Ranbo-codez/chaipi/enclosure/case-landscape/tools/fit_report.txt

ChAIpi landscape case fit report (generated by enclosure/tools/build_slab.py)
size 180.0 x 76.0 x 25.9 mm
box check (layout.py): 0 collisions, 0 spots under 0.5 mm
real-mesh check: no parts cut into each other
