Ranbo-codez/chaipi/enclosure/case-portrait/tools/fit_report.txt

ChAIpi portrait case fit report (generated by enclosure/tools/build_slab.py)
size 100.0 x 148.0 x 25.9 mm
box check (layout.py): 0 collisions, 0 spots under 0.5 mm
real-mesh check: no parts cut into each other
