Ranbo-codez/chaipi/enclosure/case/tools/fit_report.txt

ChAIpi case fit report (generated by build_case.py)
closed thickness 36.3 mm; base 89.2 x 60.5 x 25.9; lid 89.2 x 53.2 x 10.4
no parts cut into each other when closed
lid swing: free from 0 to 180 degrees
