Ranbo-codez/chaipi/enclosure/case/renders/hinge.png

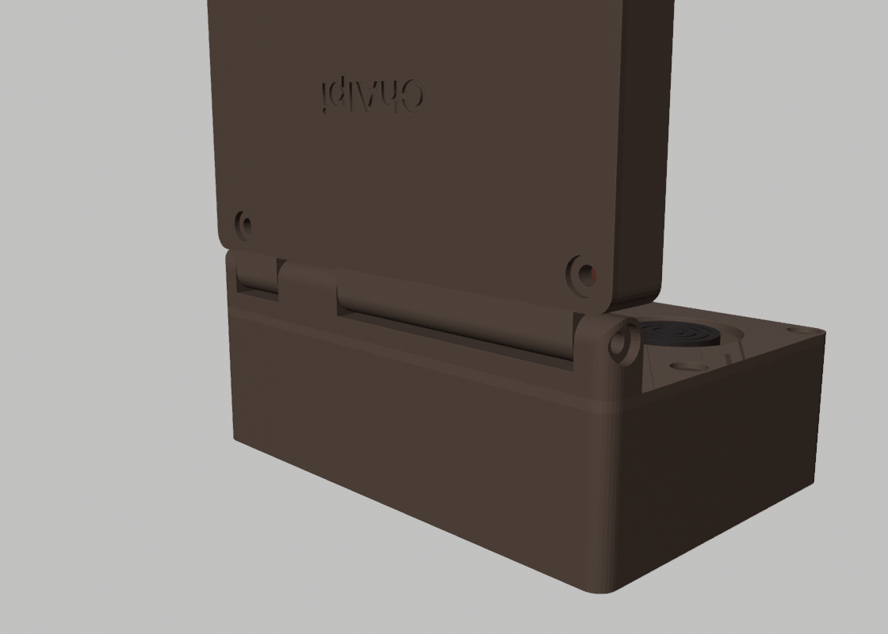
enclosure/case/renders/hinge.png
