Ranbo-codez/chaipi/enclosure/case/stl/assembly_closed.stl

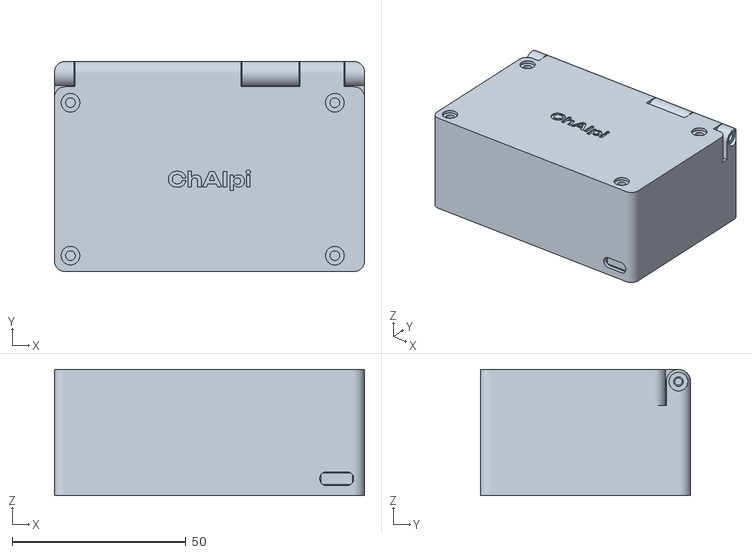
[picture p25: CAD file, 2026-10-29]
enclosure/case/stl/assembly_closed.stl
89.2 x 60.5 x 36.3
