Ranbo-codez/chaipi/enclosure/case-landscape/stl/assembly.stl

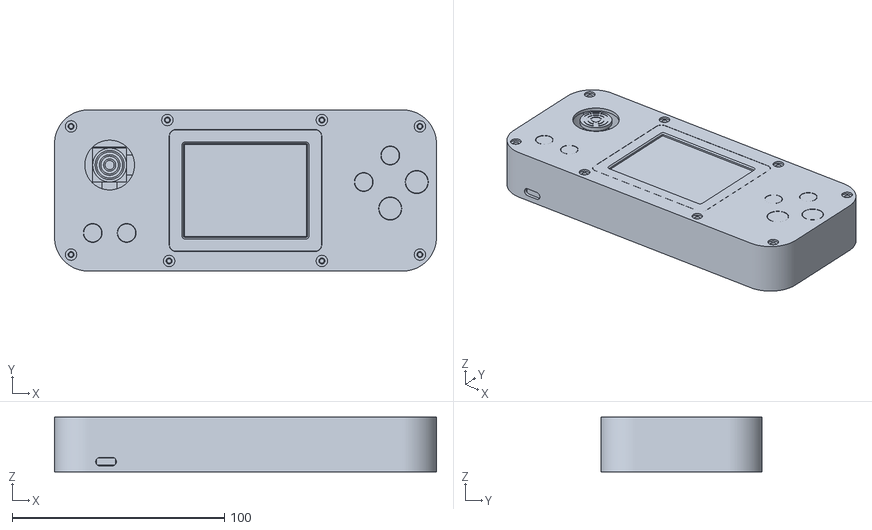
[picture p26: CAD file, 2026-10-29]
enclosure/case-landscape/stl/assembly.stl
180.0 x 76.0 x 25.9
