Ranbo-codez/chaipi/enclosure/case-portrait/stl/assembly.stl

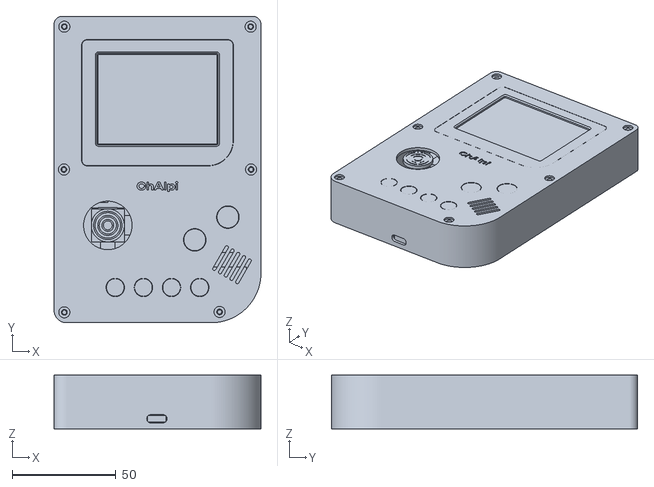
[picture p27: CAD file, 2026-10-29]
enclosure/case-portrait/stl/assembly.stl
100.0 x 148.0 x 25.9
