Ranbo-codez/chaipi/enclosure/case-landscape/stl/assembled/23 joystick.stl

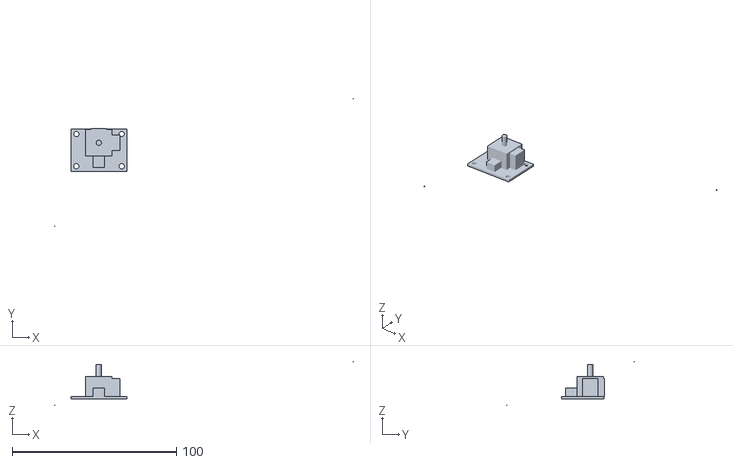
[picture p28: CAD file, 2026-10-29]
enclosure/case-landscape/stl/assembled/23 joystick.stl
182.0 x 78.0 x 26.9
