Ranbo-codez/chaipi/enclosure/case-landscape/stl/components/heatsinks.stl

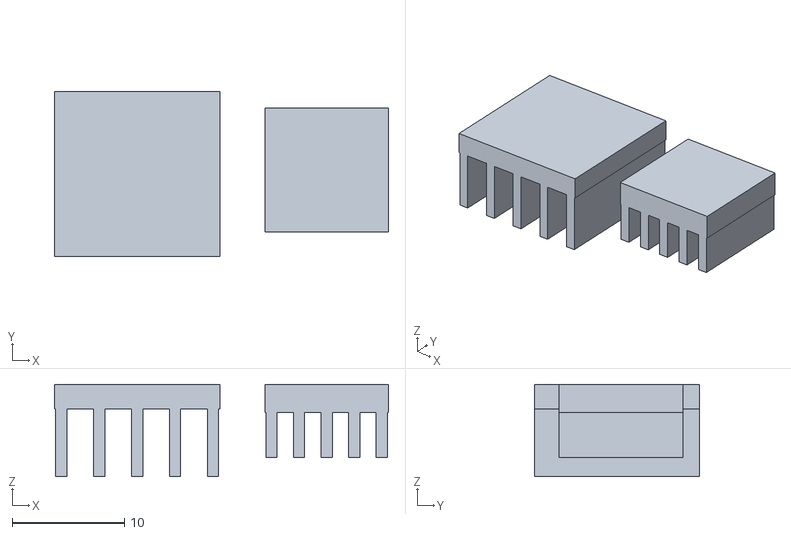
[picture p29: CAD file, 2026-10-29]
enclosure/case-landscape/stl/components/heatsinks.stl
29.7 x 14.7 x 8.20
