Ranbo-codez/chaipi/enclosure/case-landscape/stl/screen_surround.stl

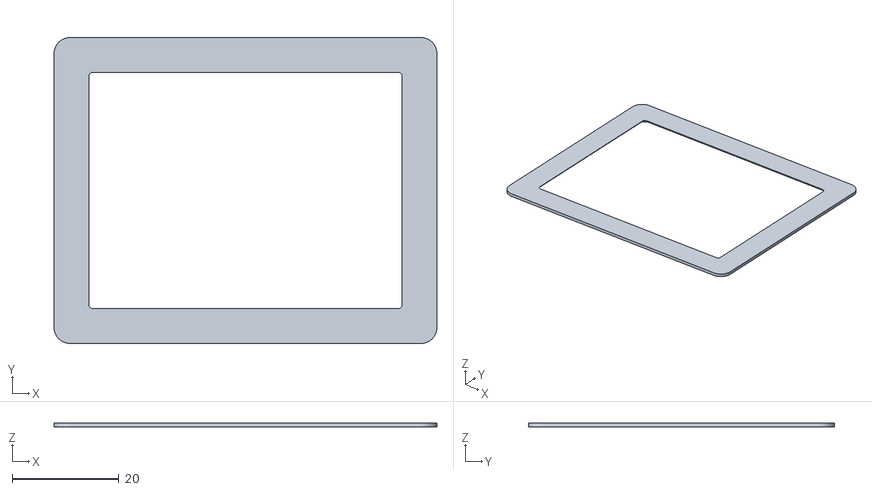
[picture p30: CAD file, 2026-10-29]
enclosure/case-landscape/stl/screen_surround.stl
71.6 x 57.2 x 0.78
