Ranbo-codez/chaipi/enclosure/case-portrait/stl/assembled/06 joystick cap.stl

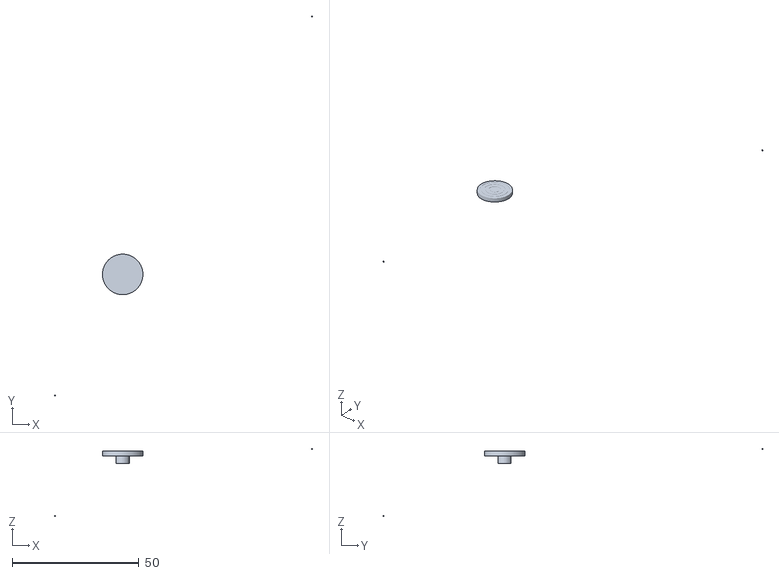
[picture p31: CAD file, 2026-10-29]
enclosure/case-portrait/stl/assembled/06 joystick cap.stl
102.0 x 150.0 x 26.9
