Ranbo-codez/chaipi/enclosure/case-portrait/stl/button_caps.stl

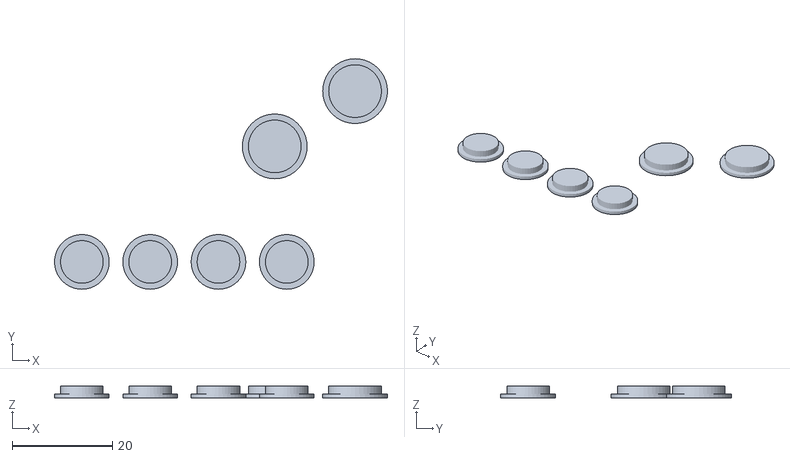
[picture p32: CAD file, 2026-10-29]
enclosure/case-portrait/stl/button_caps.stl
66.3 x 45.9 x 2.35
