Ranbo-codez/chaipi/enclosure/case-portrait/stl/components/battery.stl

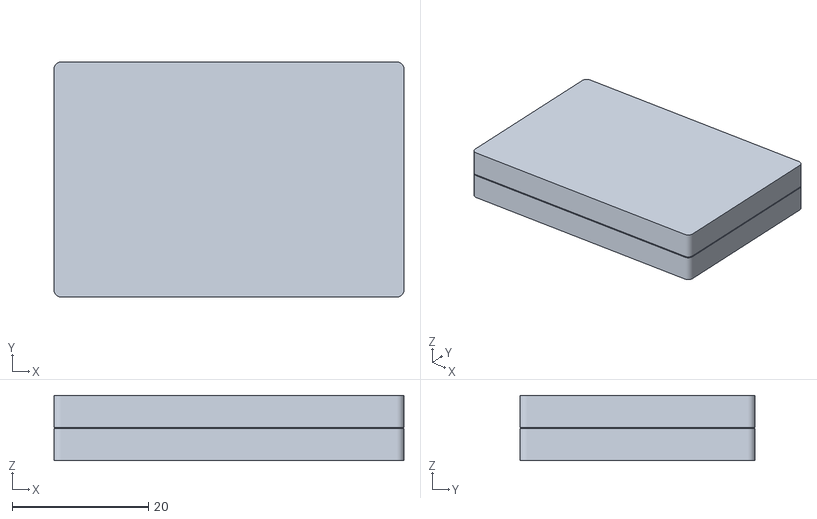
[picture p33: CAD file, 2026-10-29]
enclosure/case-portrait/stl/components/battery.stl
51.4 x 34.5 x 9.60
