Ranbo-codez/chaipi/enclosure/case/stl/assembled/03 button carrier.stl

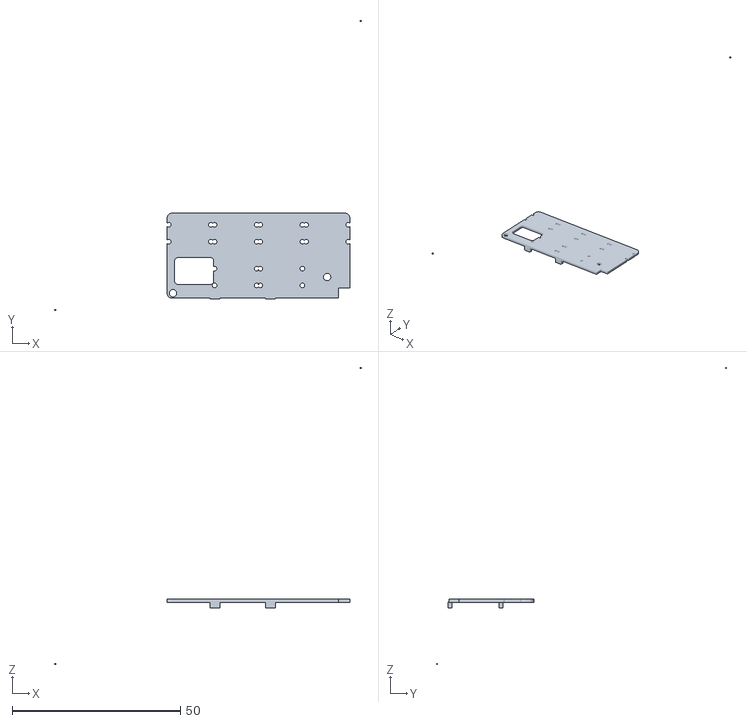
[picture p34: CAD file, 2026-10-29]
enclosure/case/stl/assembled/03 button carrier.stl
91.2 x 86.3 x 88.4
