Ranbo-codez/chaipi/enclosure/case/stl/components/screen_picture.stl

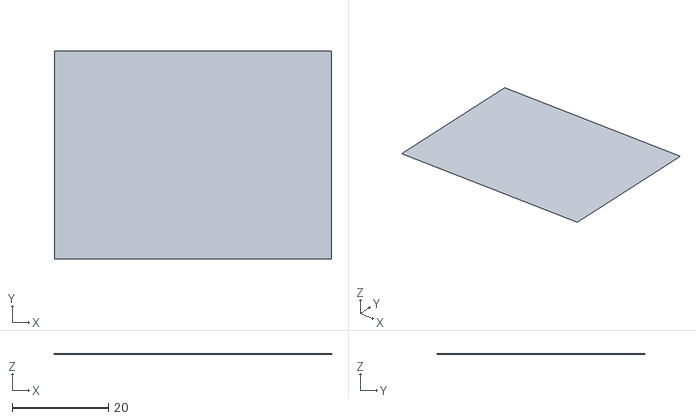
[picture p35: CAD file, 2026-10-29]
enclosure/case/stl/components/screen_picture.stl
57.6 x 43.2 x 0.1
