Ranbo-codez/chaipi/enclosure/case/stl/fit_test.stl

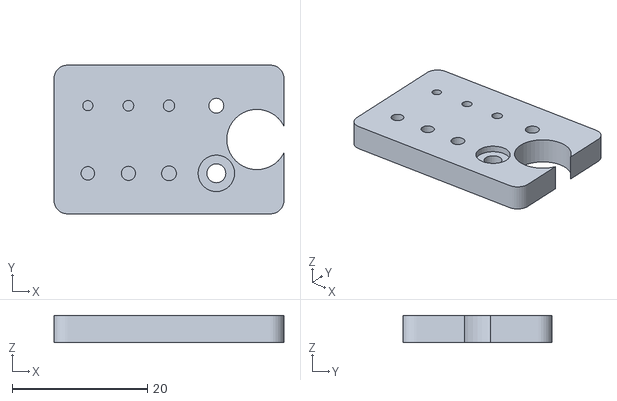
[picture p36: CAD file, 2026-10-29]
enclosure/case/stl/fit_test.stl
34.0 x 22.0 x 4.00
