Ranbo-codez/chaipi/enclosure/logo-badge/badge_ink.stl

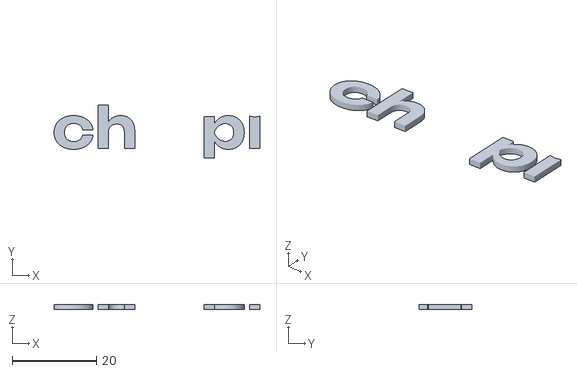
[picture p37: CAD file, 2026-10-29]
enclosure/logo-badge/badge_ink.stl
48.8 x 12.5 x 1.20
