Ranbo-codez/chaipi/enclosure/case-landscape/stl/components/Pi_connectors.stl

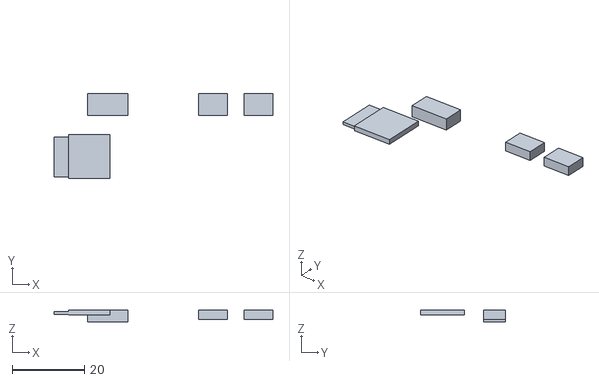
[picture p39: CAD file, 2026-10-29]
enclosure/case-landscape/stl/components/Pi_connectors.stl
60.5 x 23.4 x 3.30
