Ranbo-codez/chaipi/enclosure/case-landscape/stl/tub.stl

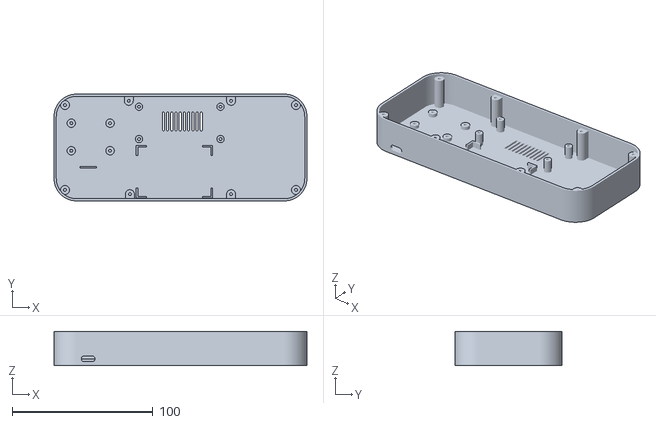
[picture p40: CAD file, 2026-10-29]
enclosure/case-landscape/stl/tub.stl
180.0 x 76.0 x 24.3
