Ranbo-codez/chaipi/enclosure/case-portrait/stl/assembled/28 USB-C breakout.stl

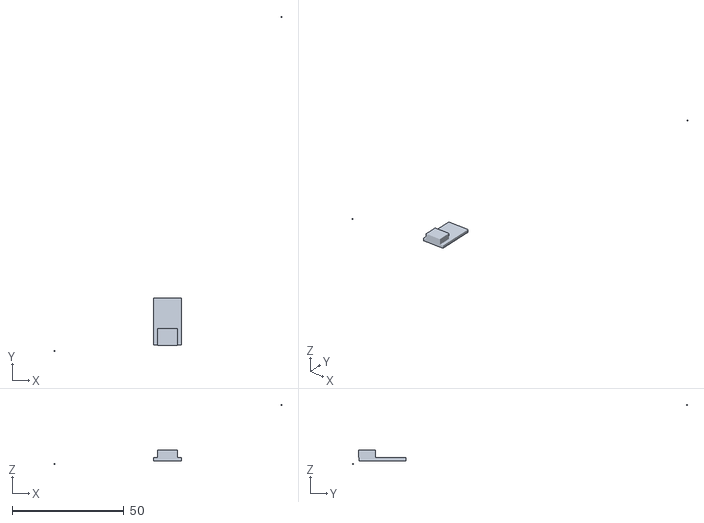
[picture p41: CAD file, 2026-10-29]
enclosure/case-portrait/stl/assembled/28 USB-C breakout.stl
102.0 x 150.0 x 26.9
