Ranbo-codez/chaipi/enclosure/case-portrait/stl/components/Pi_Zero_2_W.stl

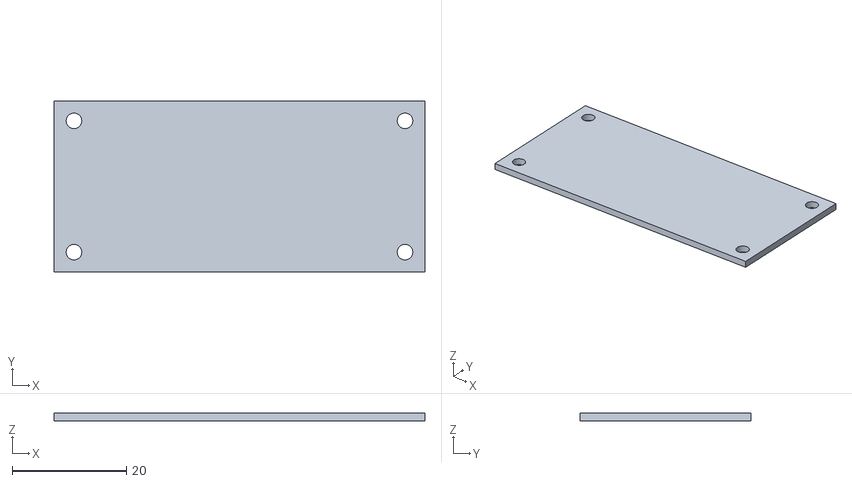
[picture p42: CAD file, 2026-10-29]
enclosure/case-portrait/stl/components/Pi_Zero_2_W.stl
65.0 x 30.0 x 1.40
