Ranbo-codez/chaipi/enclosure/case-portrait/stl/screen_surround.stl

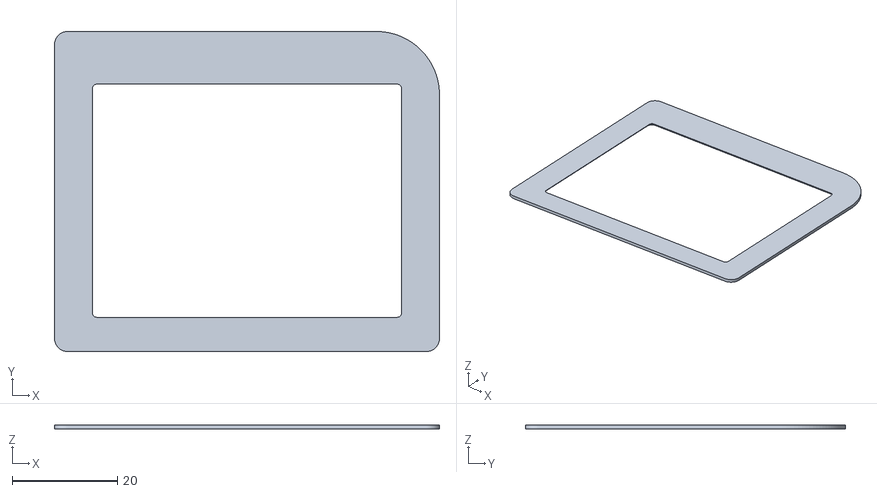
[picture p43: CAD file, 2026-10-29]
enclosure/case-portrait/stl/screen_surround.stl
73.0 x 60.7 x 0.78
