Ranbo-codez/chaipi/enclosure/case/stl/assembled/20 screen.stl

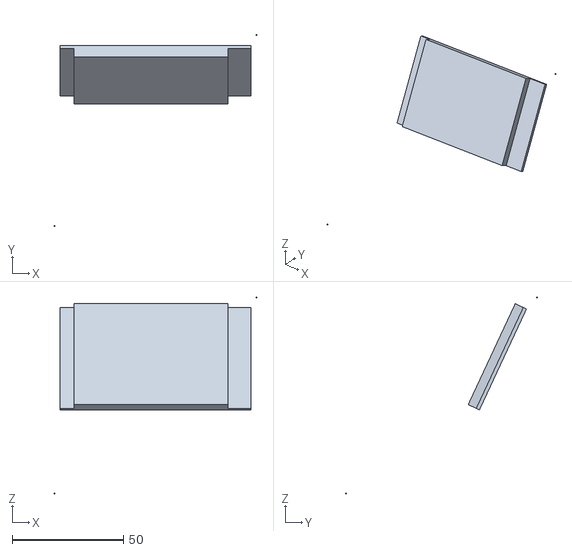
[picture p44: CAD file, 2026-10-29]
enclosure/case/stl/assembled/20 screen.stl
91.2 x 86.3 x 88.4
