Ranbo-codez/chaipi/enclosure/case/stl/lid_back_cover.stl

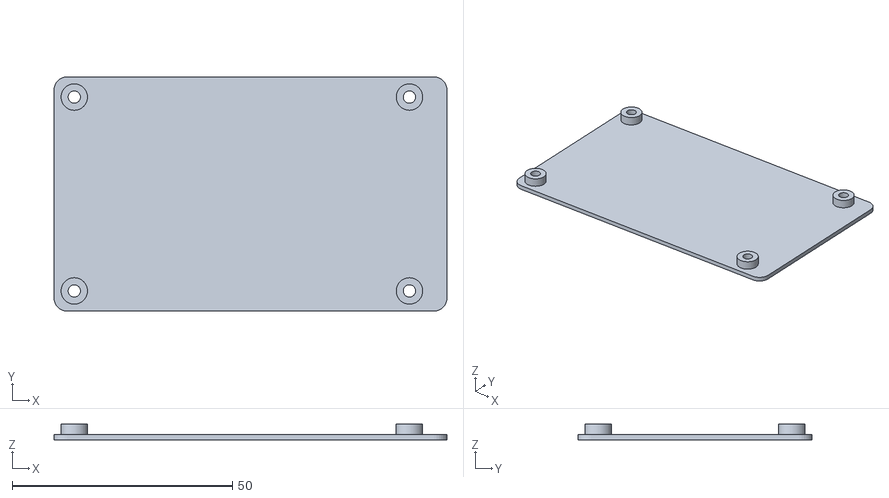
[picture p45: CAD file, 2026-10-29]
enclosure/case/stl/lid_back_cover.stl
89.2 x 53.2 x 3.60
