Ranbo-codez/chaipi/enclosure/logo-badge/badge_plate.stl

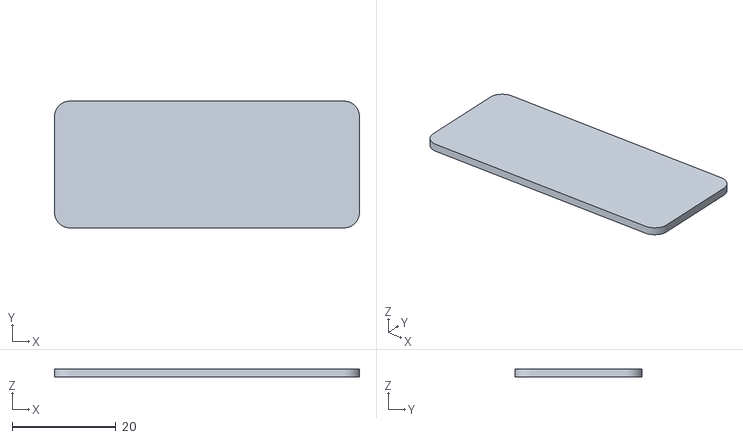
[picture p46: CAD file, 2026-10-29]
enclosure/logo-badge/badge_plate.stl
58.7 x 24.4 x 1.60
