Ranbo-codez/chaipi/enclosure/case-landscape/stl/assembled/06 joystick cap.stl

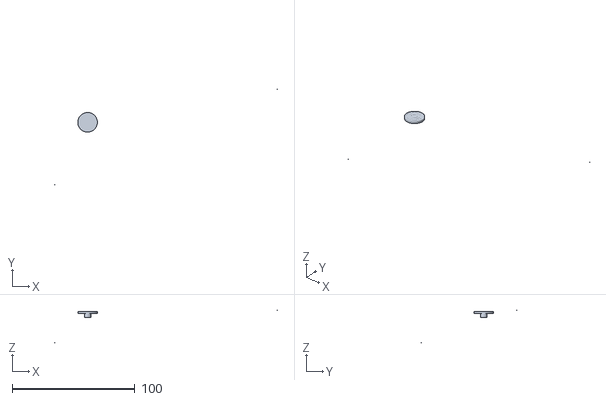
[picture p47: CAD file, 2026-10-29]
enclosure/case-landscape/stl/assembled/06 joystick cap.stl
182.0 x 78.0 x 26.9
