Ranbo-codez/chaipi/enclosure/case-landscape/stl/button_caps.stl

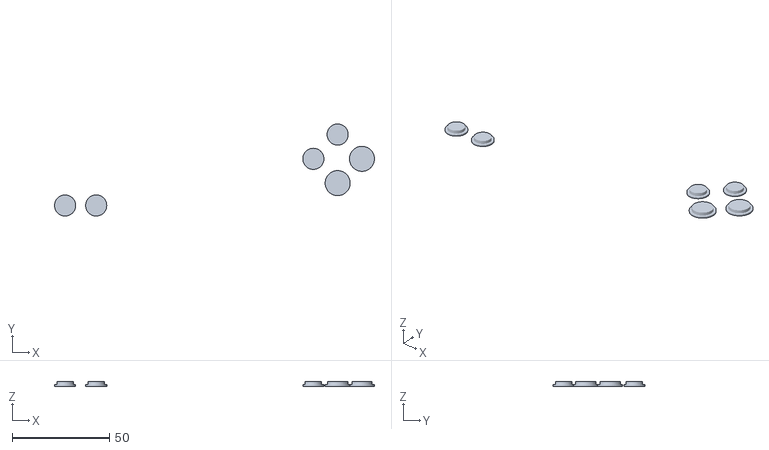
[picture p48: CAD file, 2026-10-29]
enclosure/case-landscape/stl/button_caps.stl
164.6 x 47.4 x 2.35
