Ranbo-codez/chaipi/enclosure/case-landscape/stl/components/MT3608_boost.stl

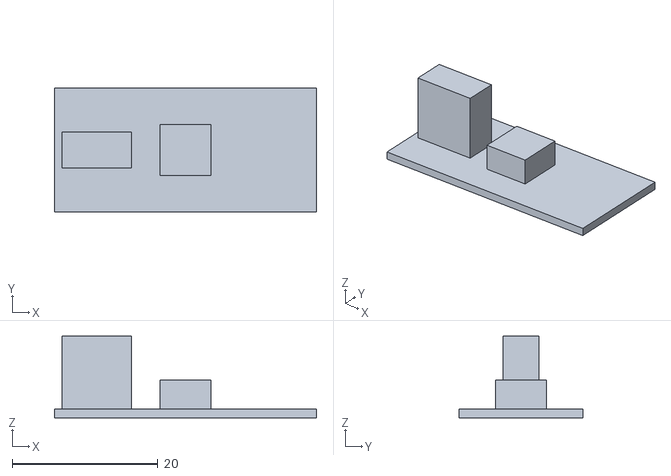
[picture p49: CAD file, 2026-10-29]
enclosure/case-landscape/stl/components/MT3608_boost.stl
36.0 x 17.0 x 11.2
