Ranbo-codez/chaipi/enclosure/case-portrait/stl/assembled/21 Pi Zero 2 W.stl

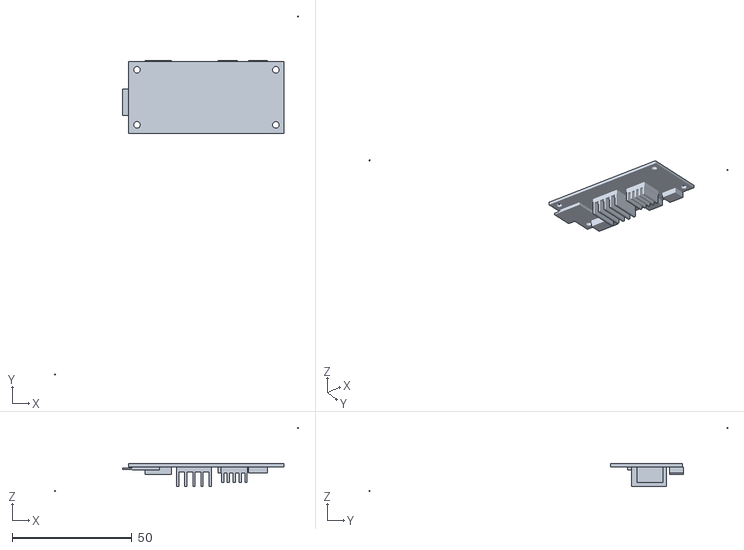
[picture p50: CAD file, 2026-10-29]
enclosure/case-portrait/stl/assembled/21 Pi Zero 2 W.stl
102.0 x 150.0 x 26.9
