Ranbo-codez/chaipi/enclosure/case-portrait/stl/joystick_cap.stl

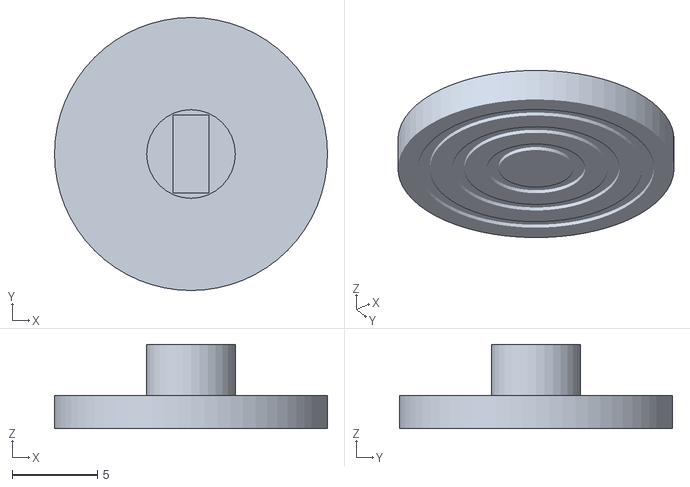
[picture p51: CAD file, 2026-10-29]
enclosure/case-portrait/stl/joystick_cap.stl
16.0 x 16.0 x 4.95
