Ranbo-codez/chaipi/enclosure/case/stl/assembled/28 USB-C breakout.stl

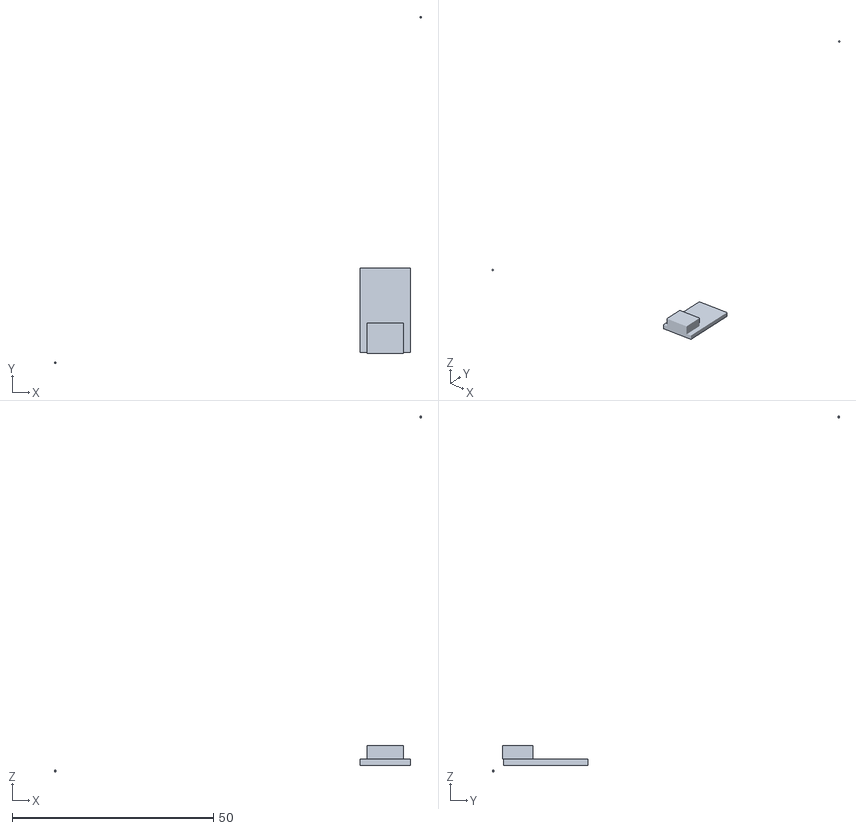
[picture p52: CAD file, 2026-10-29]
enclosure/case/stl/assembled/28 USB-C breakout.stl
91.2 x 86.3 x 88.4
