Ranbo-codez/chaipi/enclosure/case/stl/button_caps.stl

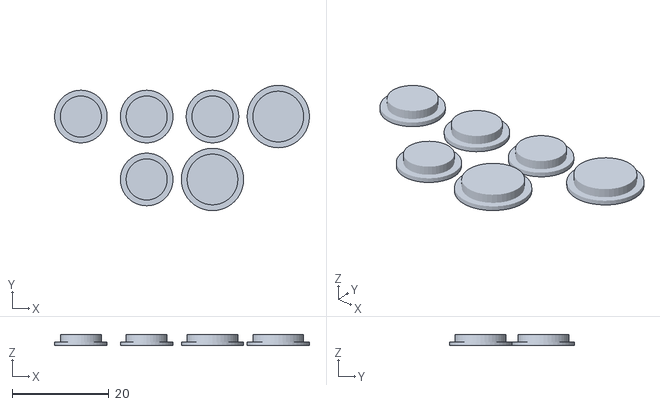
[picture p53: CAD file, 2026-10-29]
enclosure/case/stl/button_caps.stl
52.7 x 25.9 x 2.35
