Ranbo-codez/chaipi/enclosure/case/stl/components/TP4056_charger.stl

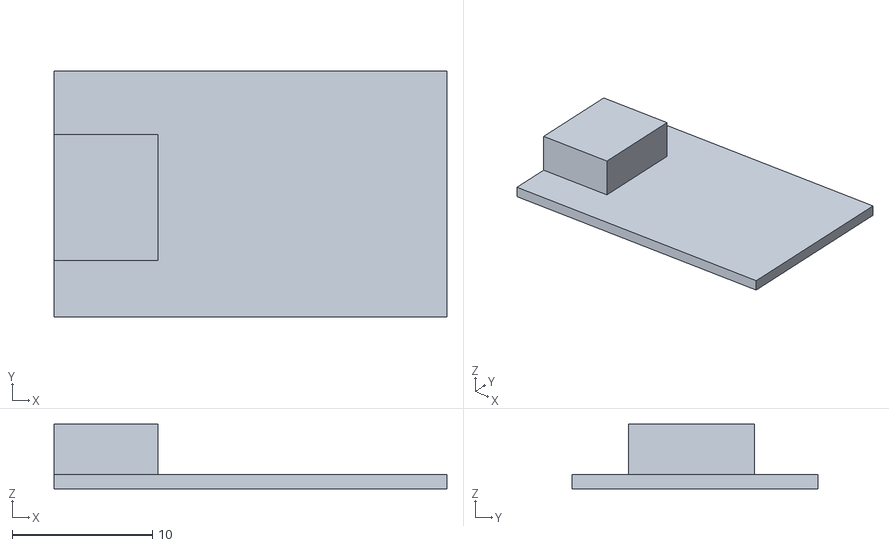
[picture p54: CAD file, 2026-10-29]
enclosure/case/stl/components/TP4056_charger.stl
28.0 x 17.5 x 4.60
