Ranbo-codez/chaipi/enclosure/logo-badge/badge_accent.stl

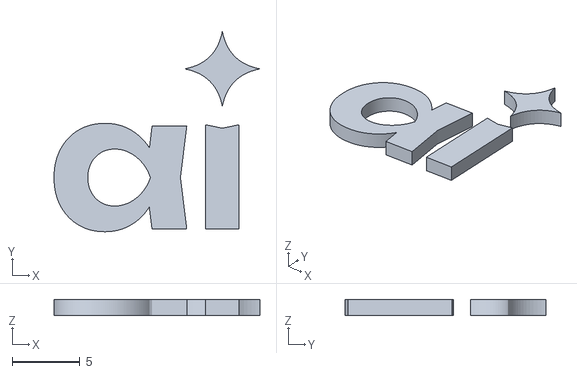
[picture p55: CAD file, 2026-10-29]
enclosure/logo-badge/badge_accent.stl
15.2 x 14.8 x 1.20
