Ranbo-codez/chaipi/enclosure/case-landscape/stl/assembled/21 Pi Zero 2 W.stl

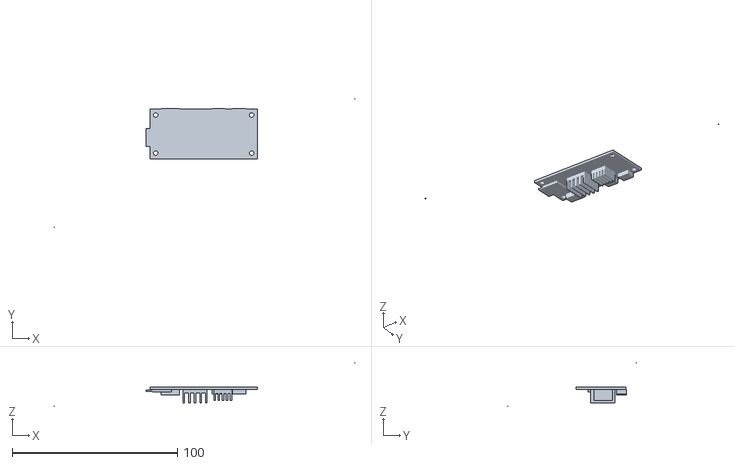
[picture p56: CAD file, 2026-10-29]
enclosure/case-landscape/stl/assembled/21 Pi Zero 2 W.stl
182.0 x 78.0 x 26.9
