Ranbo-codez/chaipi/enclosure/case-landscape/stl/button_carrier_diamond.stl

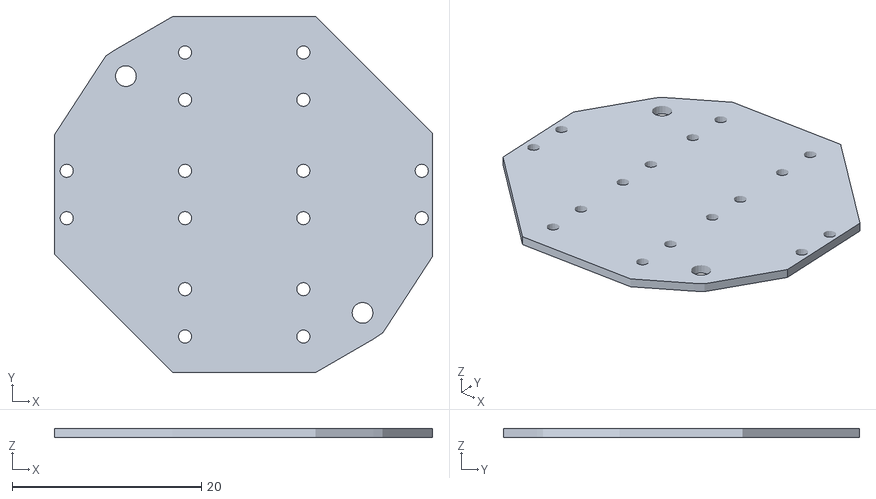
[picture p57: CAD file, 2026-10-29]
enclosure/case-landscape/stl/button_carrier_diamond.stl
40.0 x 37.6 x 1.00
