Ranbo-codez/chaipi/enclosure/case-portrait/stl/assembled/24 DS3231 clock.stl

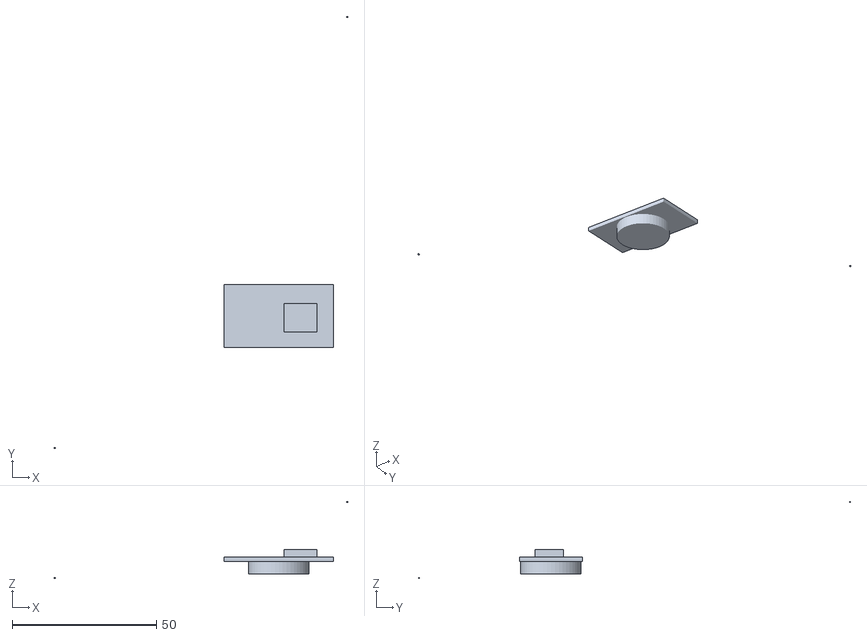
[picture p58: CAD file, 2026-10-29]
enclosure/case-portrait/stl/assembled/24 DS3231 clock.stl
102.0 x 150.0 x 26.9
