Ranbo-codez/chaipi/enclosure/case-portrait/stl/top_plate.stl

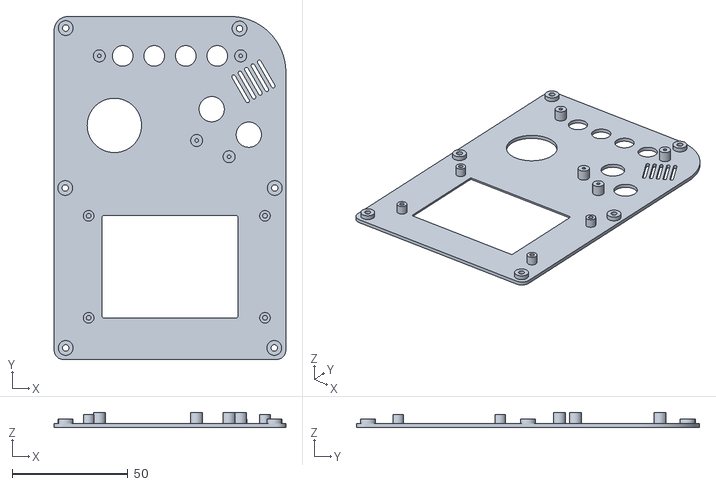
[picture p60: CAD file, 2026-10-29]
enclosure/case-portrait/stl/top_plate.stl
100.0 x 148.0 x 6.40
