Ranbo-codez/chaipi/enclosure/case/stl/assembled/06 joystick cap.stl

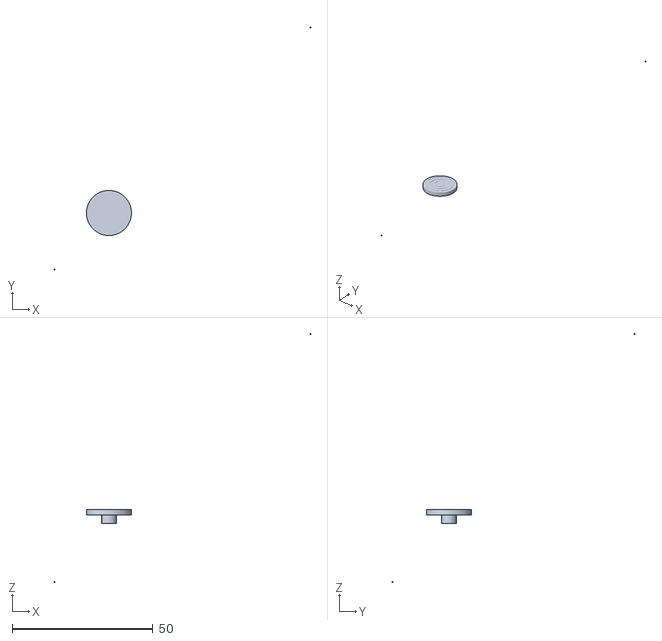
[picture p61: CAD file, 2026-10-29]
enclosure/case/stl/assembled/06 joystick cap.stl
91.2 x 86.3 x 88.4
