Ranbo-codez/chaipi/enclosure/case/stl/components/buttons.stl

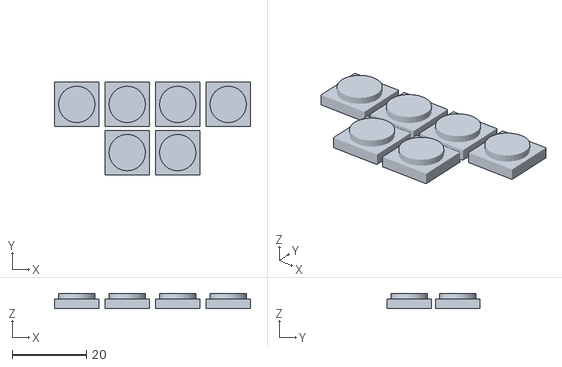
[picture p62: CAD file, 2026-10-29]
enclosure/case/stl/components/buttons.stl
52.8 x 25.0 x 4.00
