Ranbo-codez/chaipi/enclosure/logo-badge/inlay_berry.stl

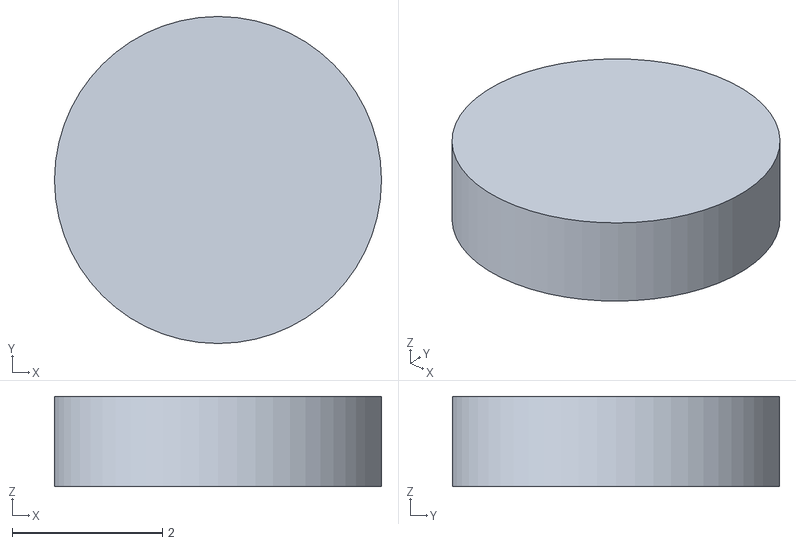
[picture p63: CAD file, 2026-10-29]
enclosure/logo-badge/inlay_berry.stl
4.36 x 4.36 x 1.20
