Ranbo-codez/chaipi/enclosure/case-landscape/stl/assembled/24 DS3231 clock.stl

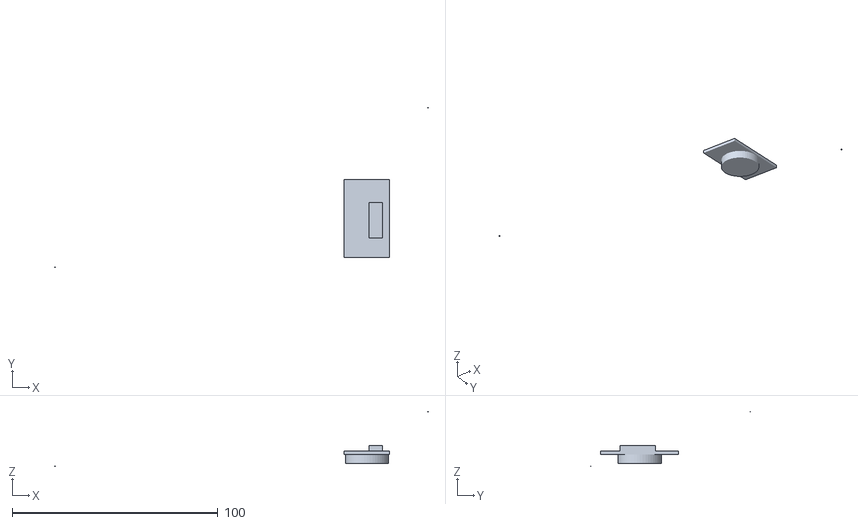
[picture p64: CAD file, 2026-10-29]
enclosure/case-landscape/stl/assembled/24 DS3231 clock.stl
182.0 x 78.0 x 26.9
