Ranbo-codez/chaipi/enclosure/case-portrait/stl/assembled/26 TP4056 charger.stl

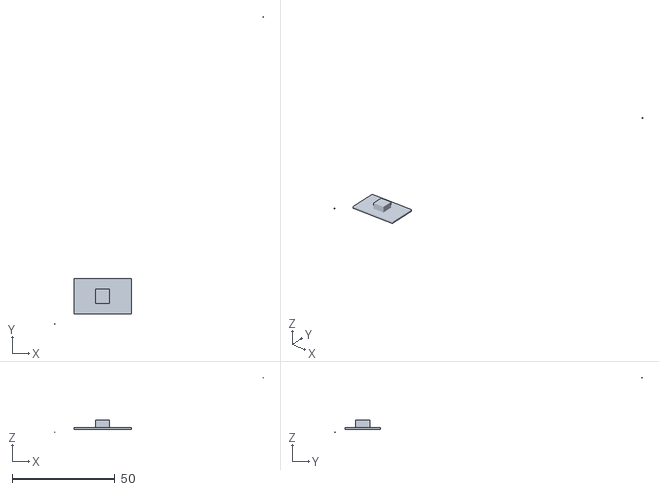
[picture p65: CAD file, 2026-10-29]
enclosure/case-portrait/stl/assembled/26 TP4056 charger.stl
102.0 x 150.0 x 26.9
