Ranbo-codez/chaipi/enclosure/case-portrait/stl/button_carrier_face_buttons.stl

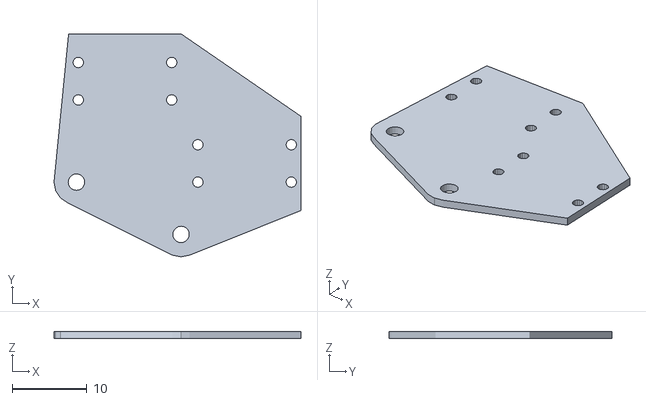
[picture p66: CAD file, 2026-10-29]
enclosure/case-portrait/stl/button_carrier_face_buttons.stl
33.1 x 29.8 x 1.00
