Ranbo-codez/chaipi/enclosure/case-portrait/stl/components/joystick.stl

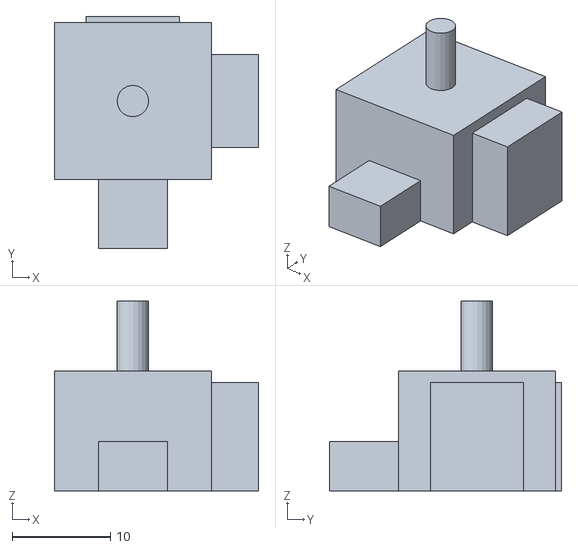
[picture p67: CAD file, 2026-10-29]
enclosure/case-portrait/stl/components/joystick.stl
20.8 x 23.6 x 19.3
