Ranbo-codez/chaipi/enclosure/case/stl/assembled/21 Pi Zero 2 W.stl

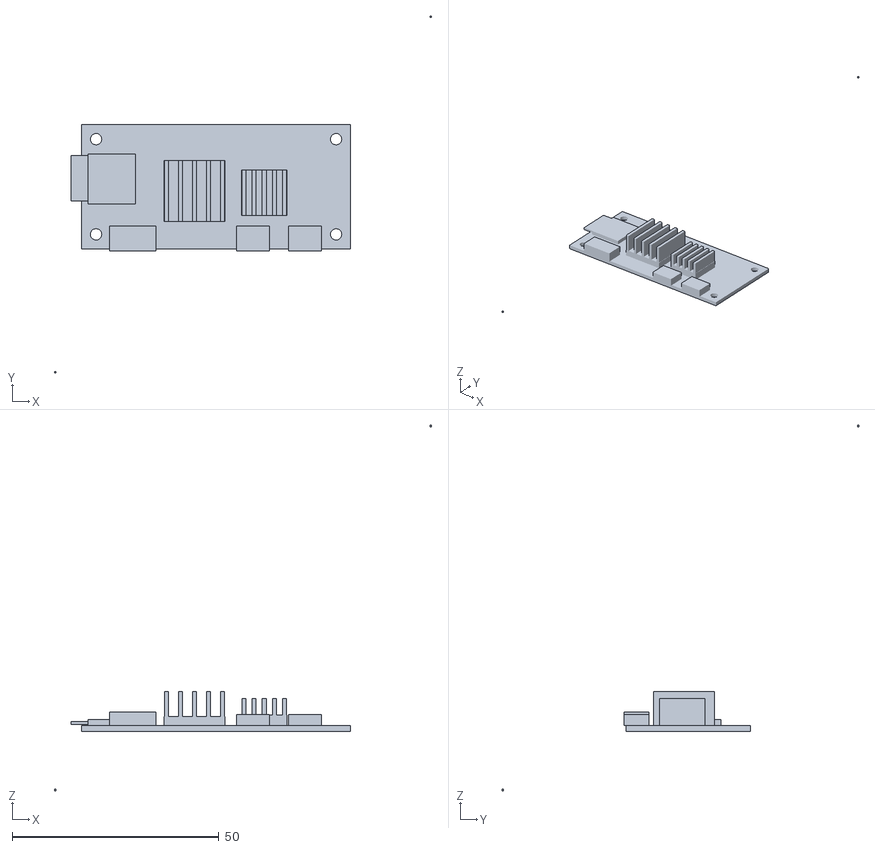
[picture p68: CAD file, 2026-10-29]
enclosure/case/stl/assembled/21 Pi Zero 2 W.stl
91.2 x 86.3 x 88.4
