Ranbo-codez/chaipi/enclosure/case/stl/button_carrier.stl

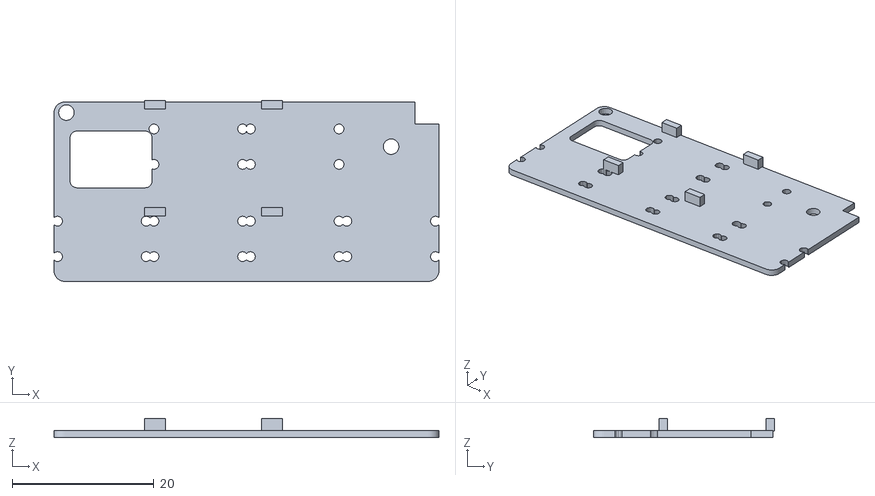
[picture p69: CAD file, 2026-10-29]
enclosure/case/stl/button_carrier.stl
54.3 x 25.5 x 2.70
