Ranbo-codez/chaipi/enclosure/case-landscape/stl/assembled/27 ADS1115.stl

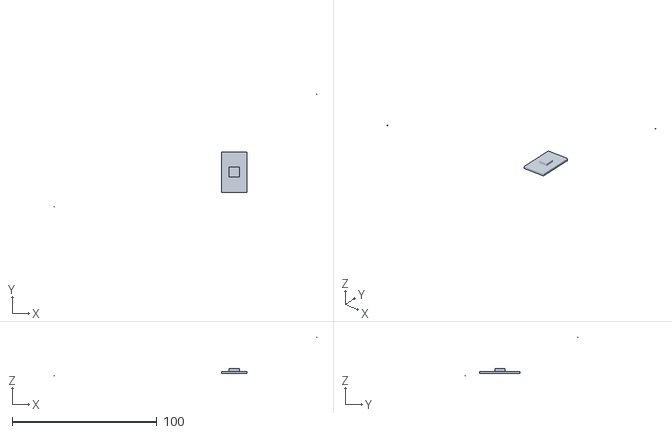
[picture p70: CAD file, 2026-10-29]
enclosure/case-landscape/stl/assembled/27 ADS1115.stl
182.0 x 78.0 x 26.9
