Ranbo-codez/chaipi/enclosure/case-portrait/stl/assembled/23 joystick.stl

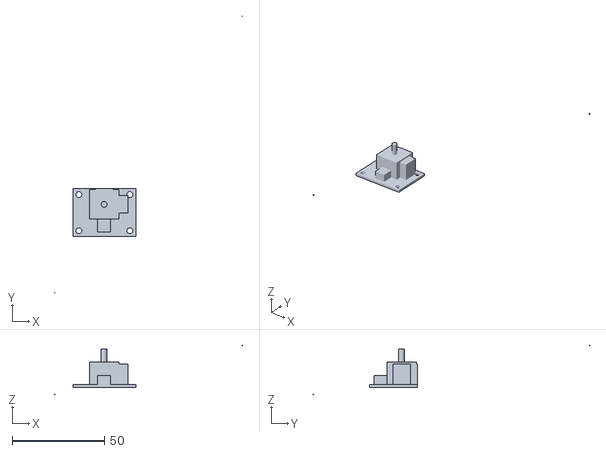
[picture p71: CAD file, 2026-10-29]
enclosure/case-portrait/stl/assembled/23 joystick.stl
102.0 x 150.0 x 26.9
