Ranbo-codez/chaipi/enclosure/case-portrait/stl/components/buttons.stl

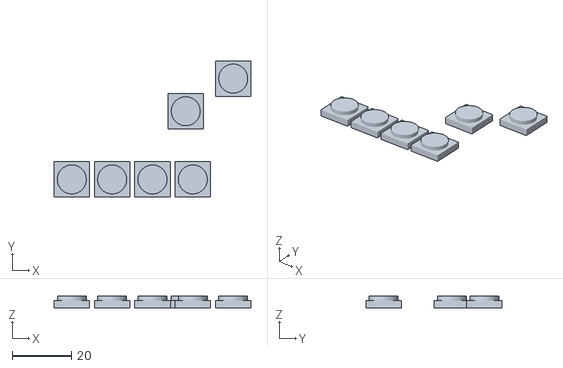
[picture p72: CAD file, 2026-10-29]
enclosure/case-portrait/stl/components/buttons.stl
66.4 x 46.0 x 4.00
