Ranbo-codez/chaipi/enclosure/case-portrait/stl/tub.stl

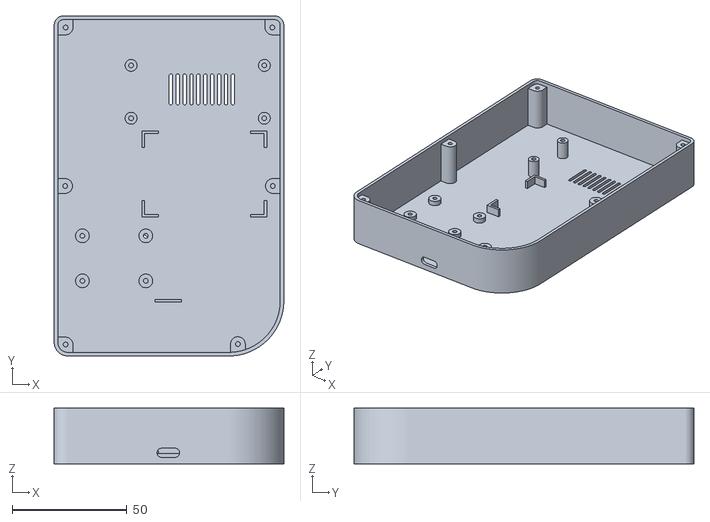
[picture p73: CAD file, 2026-10-29]
enclosure/case-portrait/stl/tub.stl
100.0 x 148.0 x 24.3
