Ranbo-codez/chaipi/enclosure/case/stl/assembled/27 ADS1115.stl

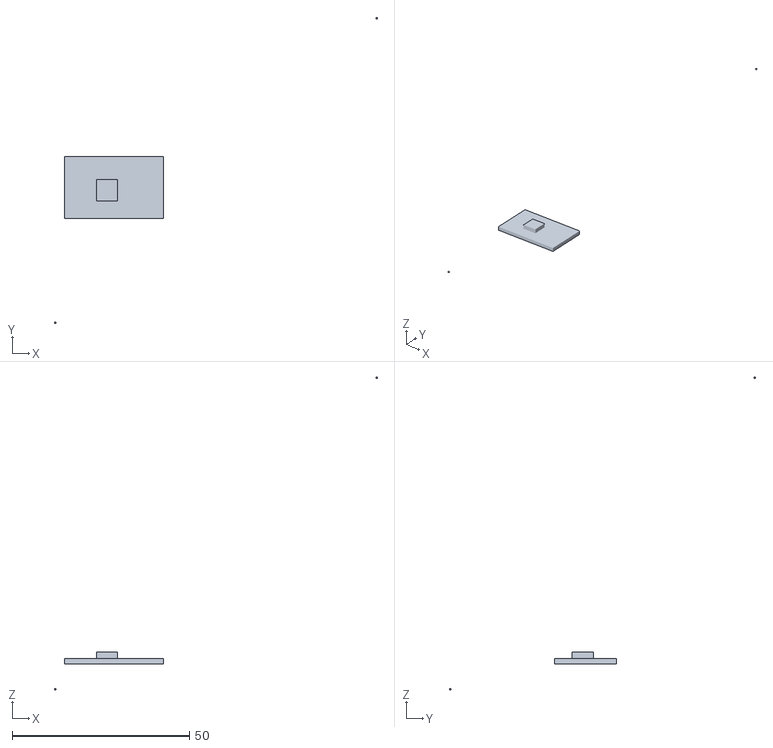
[picture p74: CAD file, 2026-10-29]
enclosure/case/stl/assembled/27 ADS1115.stl
91.2 x 86.3 x 88.4
