Ranbo-codez/chaipi/enclosure/case/stl/base_tub.stl

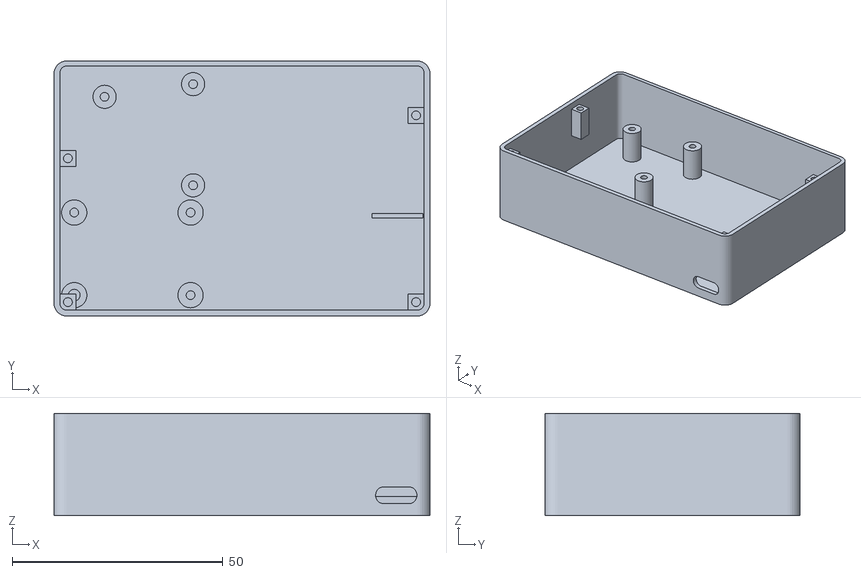
[picture p75: CAD file, 2026-10-29]
enclosure/case/stl/base_tub.stl
89.2 x 60.5 x 24.3
