Ranbo-codez/chaipi/enclosure/case/stl/components/USB-C_breakout.stl

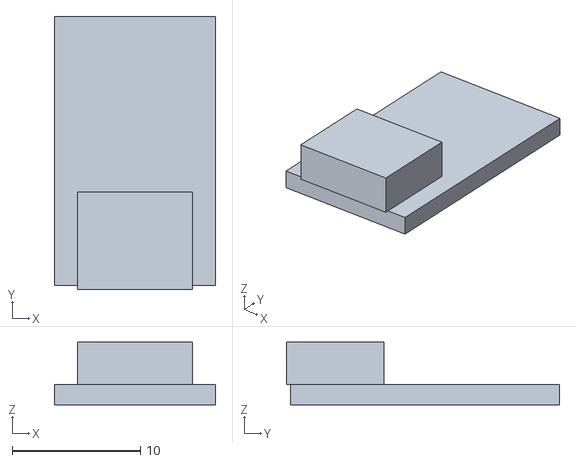
[picture p76: CAD file, 2026-10-29]
enclosure/case/stl/components/USB-C_breakout.stl
12.6 x 21.3 x 4.90
