Ranbo-codez/chaipi/enclosure/case-landscape/stl/assembled/22 battery.stl

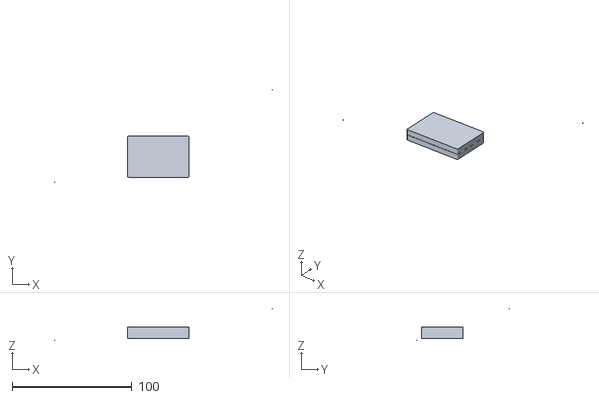
[picture p77: CAD file, 2026-10-29]
enclosure/case-landscape/stl/assembled/22 battery.stl
182.0 x 78.0 x 26.9
