Ranbo-codez/chaipi/enclosure/case-landscape/stl/components/ADS1115.stl

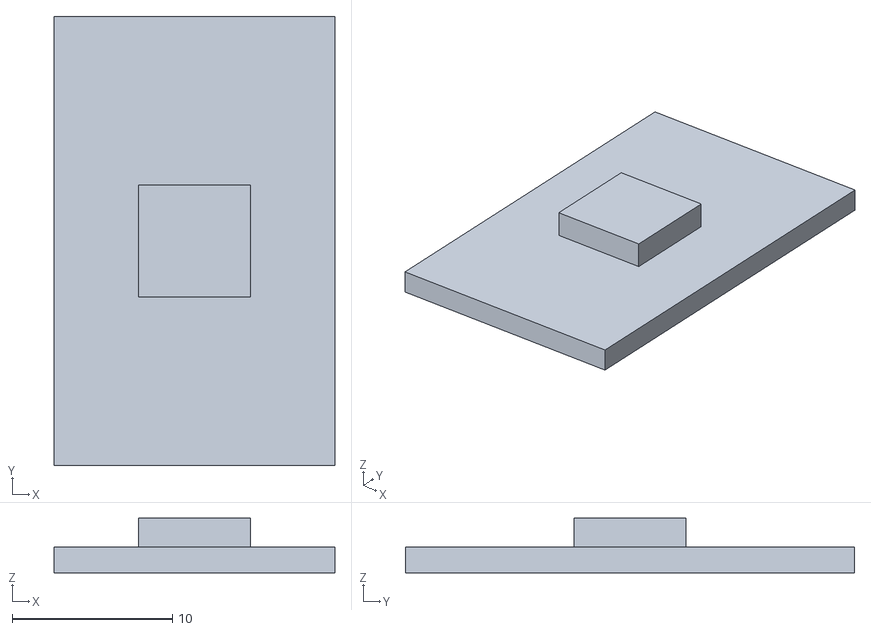
[picture p78: CAD file, 2026-10-29]
enclosure/case-landscape/stl/components/ADS1115.stl
17.5 x 28.0 x 3.40
