Ranbo-codez/chaipi/enclosure/case-landscape/stl/top_plate.stl

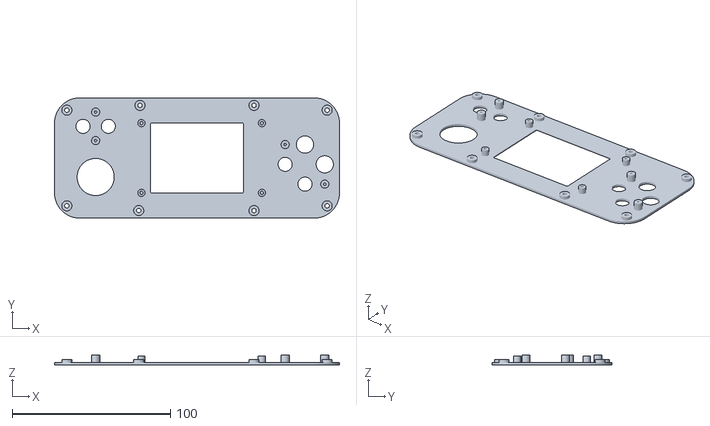
[picture p79: CAD file, 2026-10-29]
enclosure/case-landscape/stl/top_plate.stl
180.0 x 76.0 x 6.40
