Ranbo-codez/chaipi/enclosure/case-portrait/stl/assembled/22 battery.stl

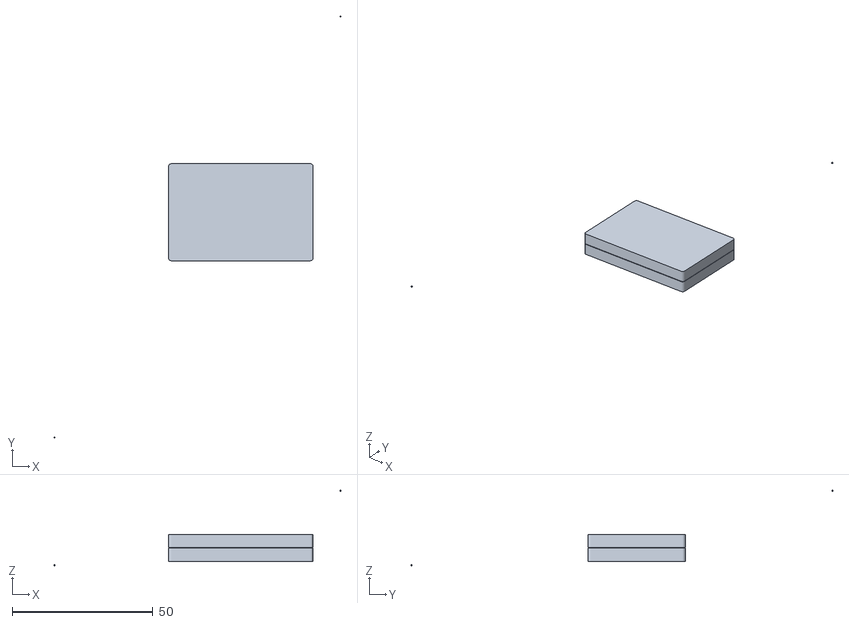
[picture p80: CAD file, 2026-10-29]
enclosure/case-portrait/stl/assembled/22 battery.stl
102.0 x 150.0 x 26.9
