Ranbo-codez/chaipi/enclosure/case-portrait/stl/button_carrier_small_keys.stl

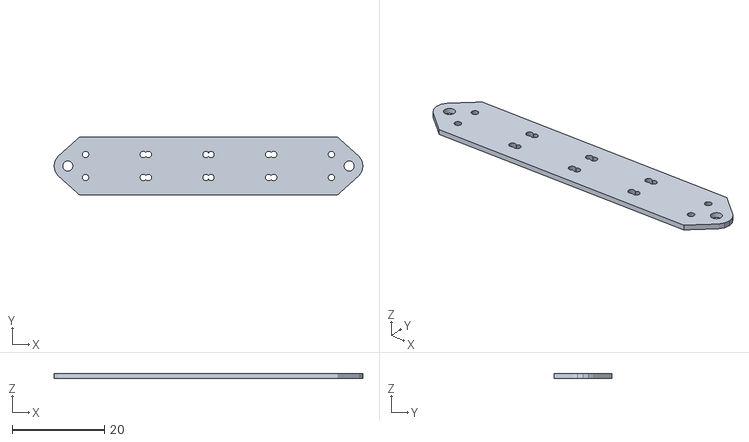
[picture p81: CAD file, 2026-10-29]
enclosure/case-portrait/stl/button_carrier_small_keys.stl
67.0 x 12.6 x 1.00
