Ranbo-codez/chaipi/enclosure/case/stl/assembled/08 lid frame.stl

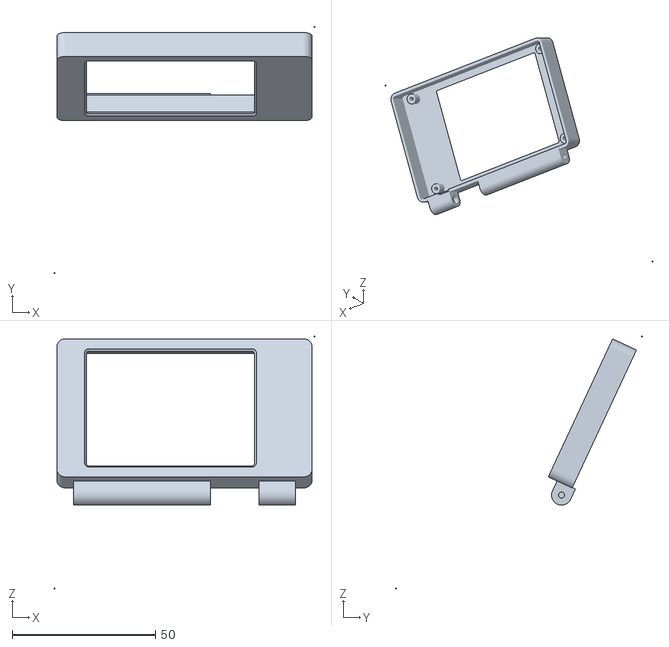
[picture p82: CAD file, 2026-10-29]
enclosure/case/stl/assembled/08 lid frame.stl
91.2 x 86.3 x 88.4
