Ranbo-codez/chaipi/enclosure/case/stl/components/screen.stl

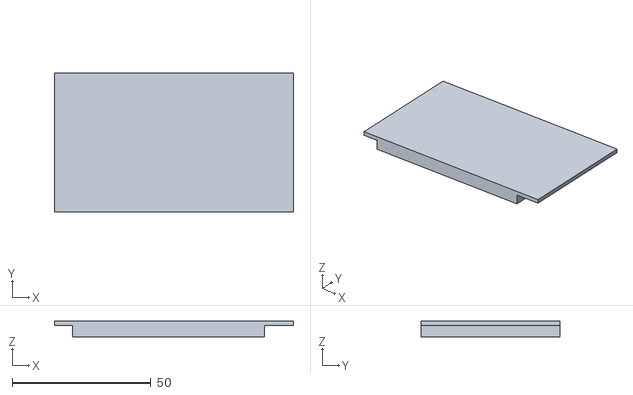
[picture p83: CAD file, 2026-10-29]
enclosure/case/stl/components/screen.stl
86.0 x 50.0 x 5.60
