Ranbo-codez/chaipi/enclosure/case/stl/hinge_block.stl

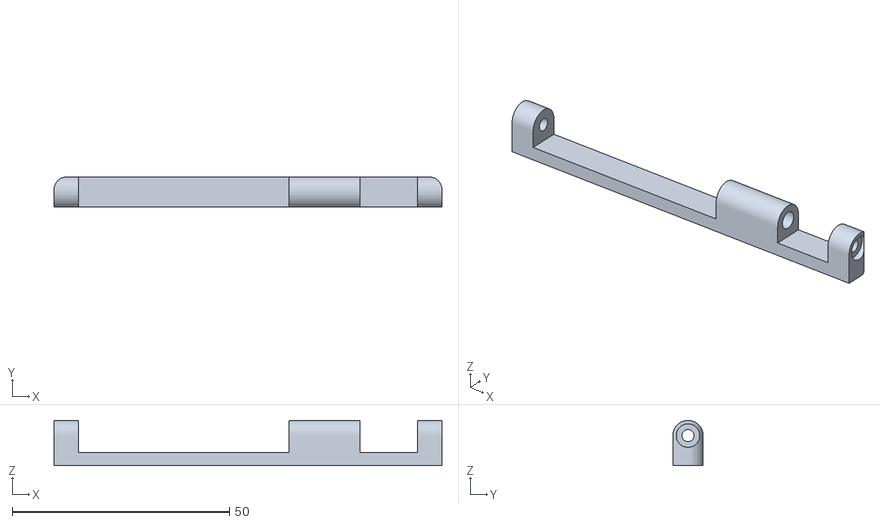
[picture p84: CAD file, 2026-10-29]
enclosure/case/stl/hinge_block.stl
89.2 x 7.00 x 10.4
