Ranbo-codez/chaipi/enclosure/case-landscape/stl/assembled/01 tub.stl

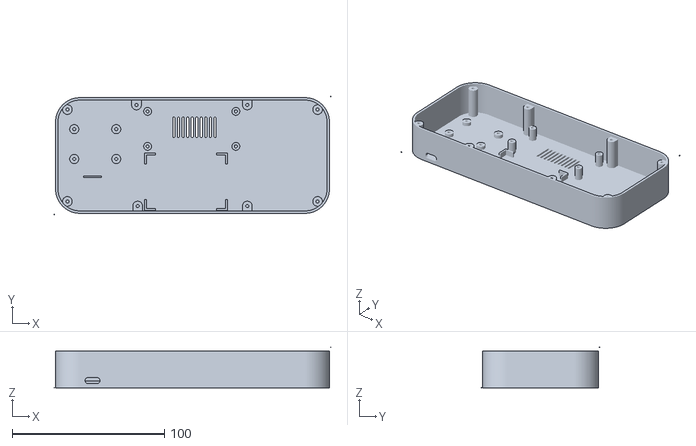
[picture p85: CAD file, 2026-10-29]
enclosure/case-landscape/stl/assembled/01 tub.stl
182.0 x 78.0 x 26.9
