Ranbo-codez/chaipi/enclosure/case-landscape/stl/button_carrier_left_keys.stl

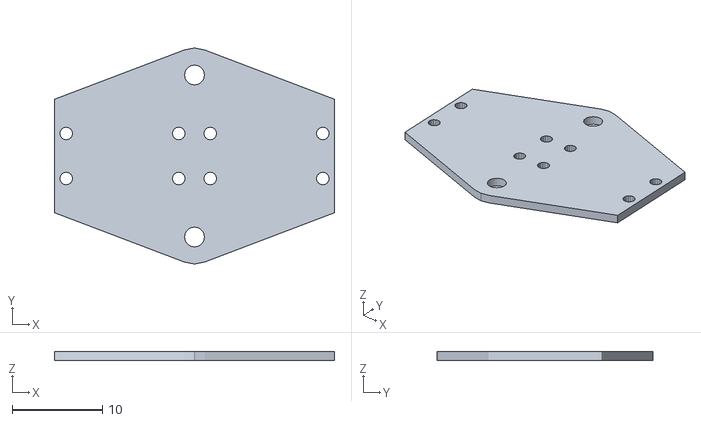
[picture p86: CAD file, 2026-10-29]
enclosure/case-landscape/stl/button_carrier_left_keys.stl
31.1 x 24.0 x 1.00
