Ranbo-codez/chaipi/enclosure/case-landscape/stl/components/screen_picture.stl

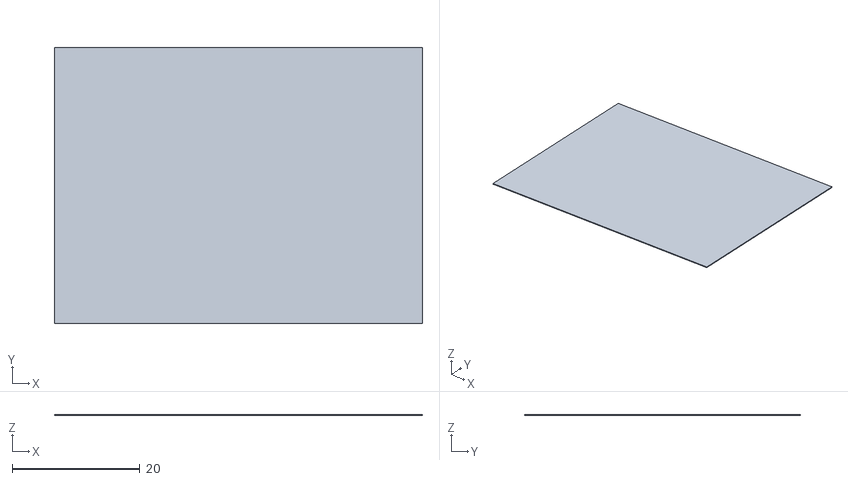
[picture p87: CAD file, 2026-10-29]
enclosure/case-landscape/stl/components/screen_picture.stl
57.6 x 43.2 x 0.16
