Ranbo-codez/chaipi/enclosure/case-portrait/stl/assembled/02 top plate.stl

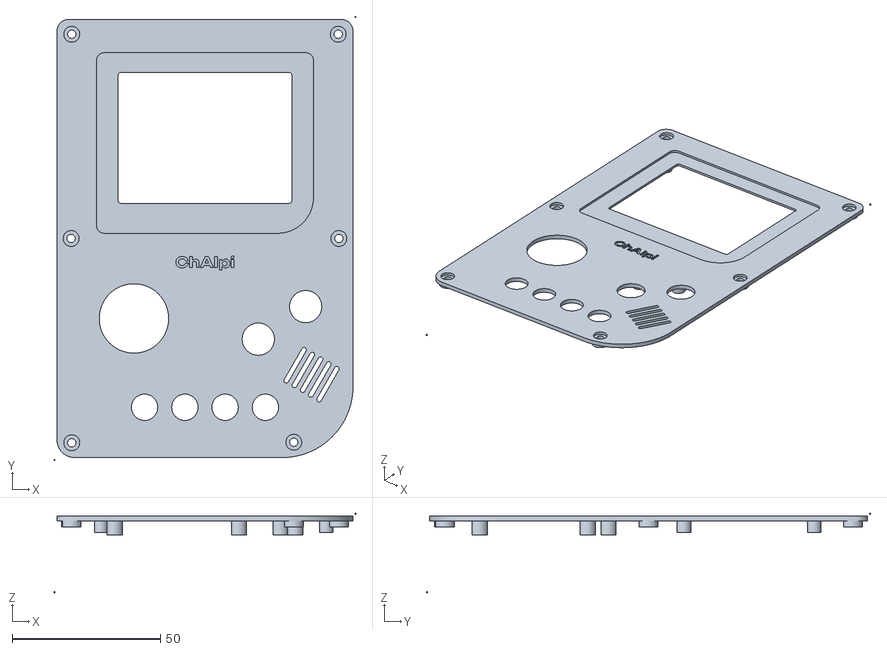
[picture p88: CAD file, 2026-10-29]
enclosure/case-portrait/stl/assembled/02 top plate.stl
102.0 x 150.0 x 26.9
