Ranbo-codez/chaipi/enclosure/case/stl/assembled/24 DS3231 clock.stl

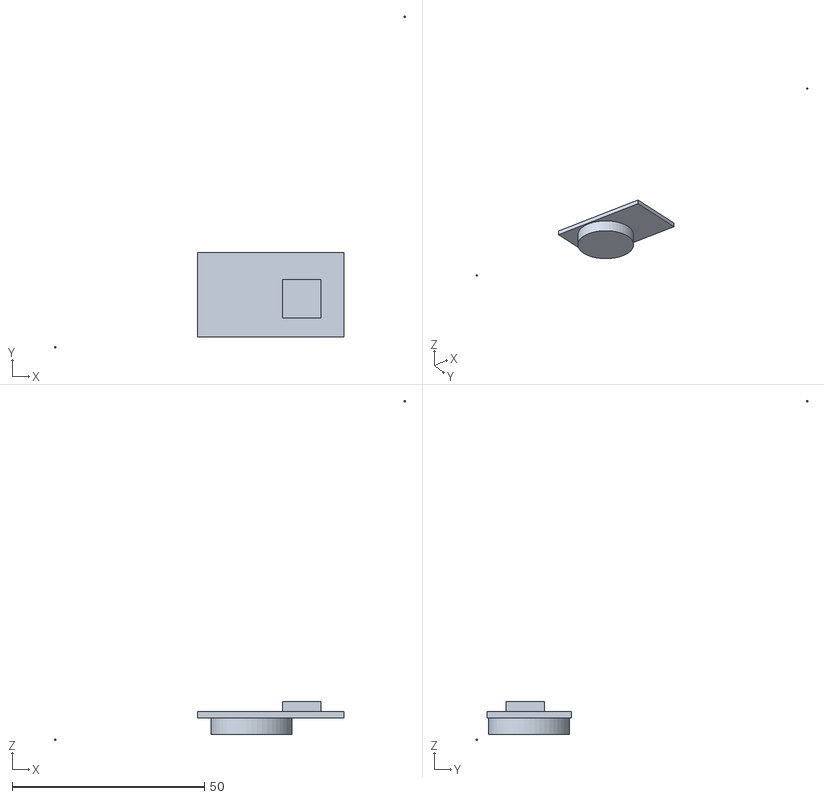
[picture p89: CAD file, 2026-10-29]
enclosure/case/stl/assembled/24 DS3231 clock.stl
91.2 x 86.3 x 88.4
