Ranbo-codez/chaipi/enclosure/case/stl/base_top_plate.stl

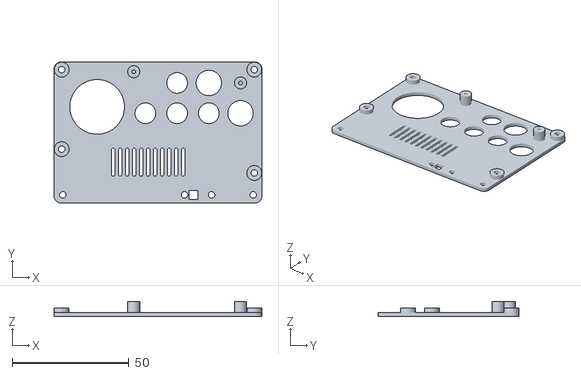
[picture p90: CAD file, 2026-10-29]
enclosure/case/stl/base_top_plate.stl
89.2 x 60.5 x 6.40
