Ranbo-codez/chaipi/enclosure/logo-badge/badge_one_piece.stl

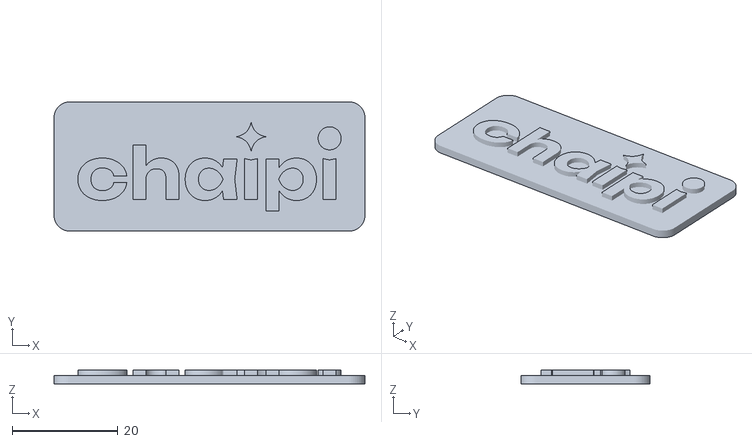
[picture p91: CAD file, 2026-10-29]
enclosure/logo-badge/badge_one_piece.stl
58.7 x 24.4 x 2.60
