Ranbo-codez/chaipi/enclosure/case-landscape/stl/assembled/04 button carrier left keys.stl

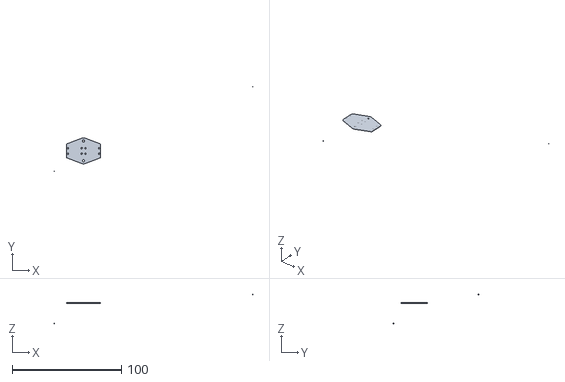
[picture p92: CAD file, 2026-10-29]
enclosure/case-landscape/stl/assembled/04 button carrier left keys.stl
182.0 x 78.0 x 26.9
