Ranbo-codez/chaipi/enclosure/case-portrait/stl/components/joystick_board.stl

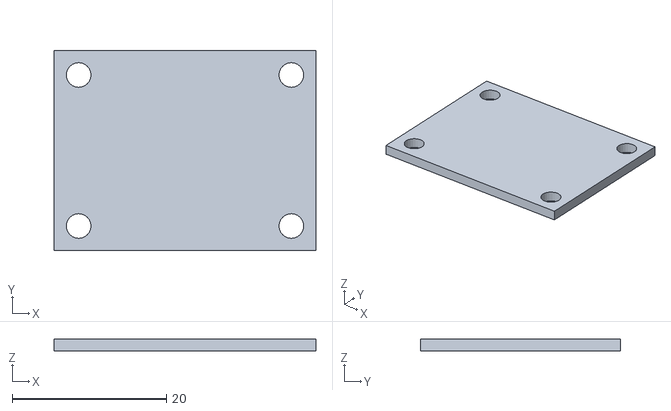
[picture p93: CAD file, 2026-10-29]
enclosure/case-portrait/stl/components/joystick_board.stl
34.0 x 26.0 x 1.60
