Ranbo-codez/chaipi/enclosure/case/stl/assembled/22 battery.stl

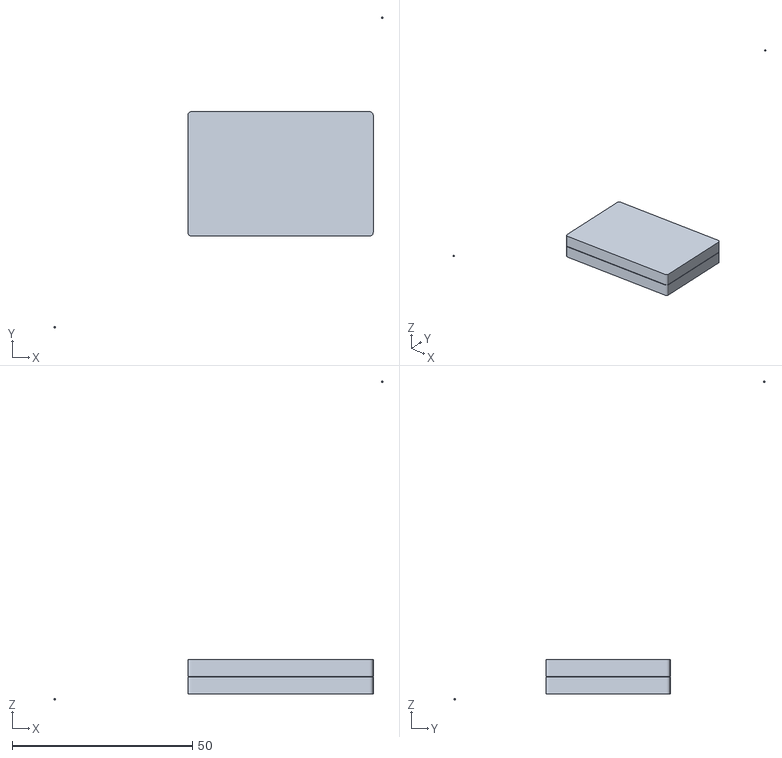
[picture p94: CAD file, 2026-10-29]
enclosure/case/stl/assembled/22 battery.stl
91.2 x 86.3 x 88.4
