Ranbo-codez/chaipi/enclosure/case/stl/lid_frame.stl

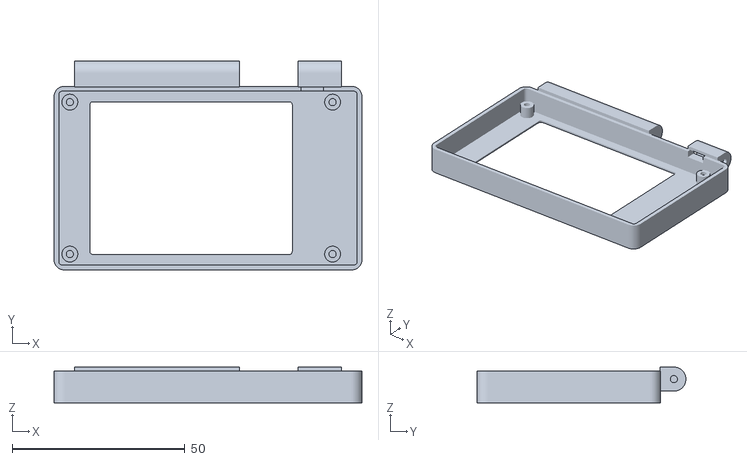
[picture p95: CAD file, 2026-10-29]
enclosure/case/stl/lid_frame.stl
89.2 x 60.5 x 10.4
