Ranbo-codez/chaipi/enclosure/case-landscape/stl/assembled/29 buttons.stl

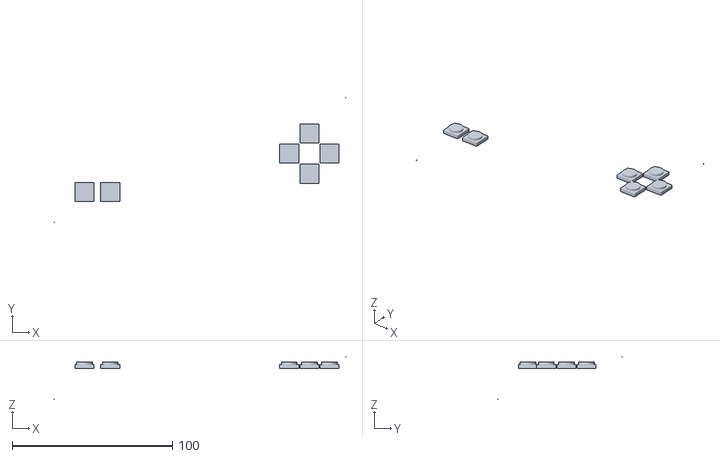
[picture p96: CAD file, 2026-10-29]
enclosure/case-landscape/stl/assembled/29 buttons.stl
182.0 x 78.0 x 26.9
