Ranbo-codez/chaipi/enclosure/case-portrait/stl/assembled/29 buttons.stl

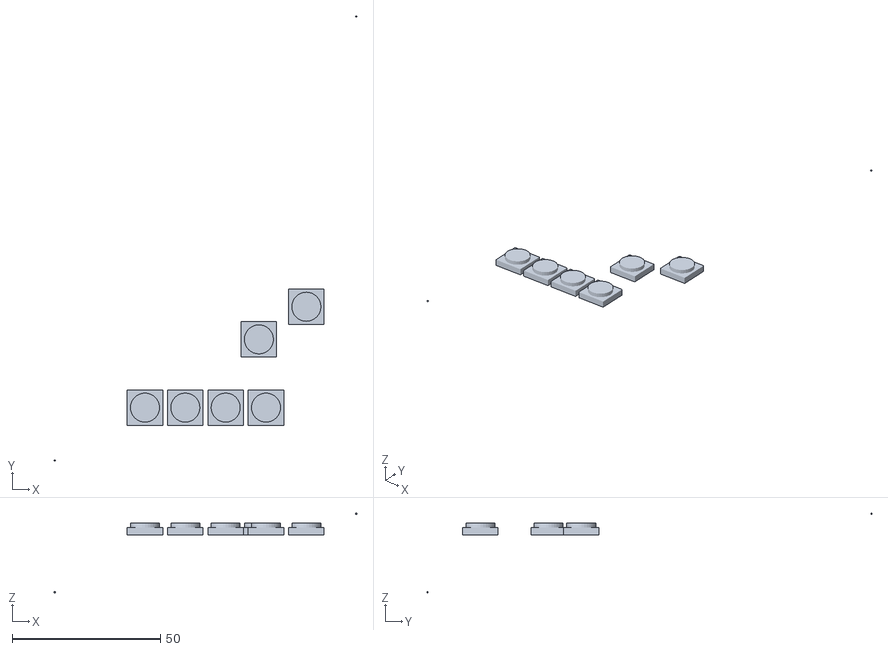
[picture p97: CAD file, 2026-10-29]
enclosure/case-portrait/stl/assembled/29 buttons.stl
102.0 x 150.0 x 26.9
