Ranbo-codez/chaipi/enclosure/case/stl/components/ADS1115.stl

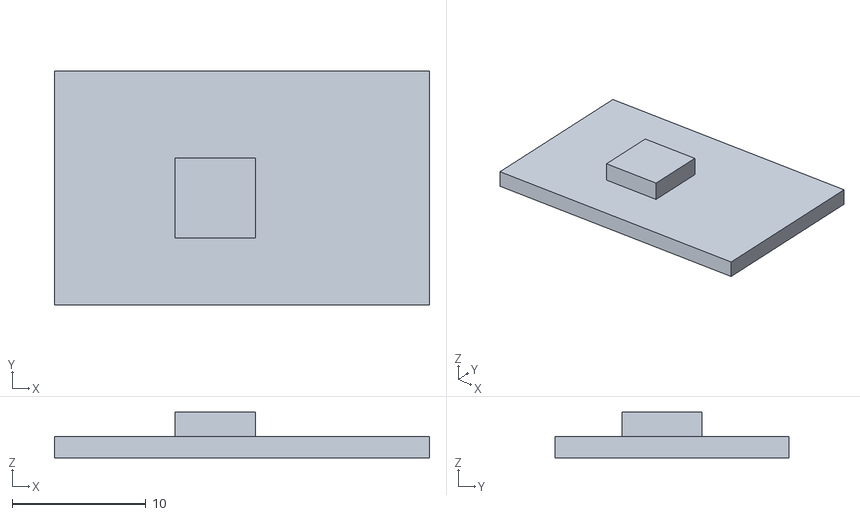
[picture p98: CAD file, 2026-10-29]
enclosure/case/stl/components/ADS1115.stl
28.0 x 17.5 x 3.40
