Ranbo-codez/chaipi/enclosure/case/stl/middle_sheet.stl

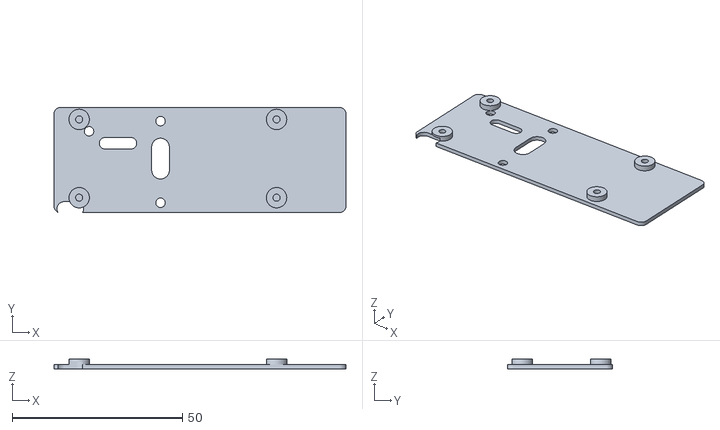
[picture p99: CAD file, 2026-10-29]
enclosure/case/stl/middle_sheet.stl
85.8 x 30.9 x 2.80
