Ranbo-codez/chaipi/enclosure/case-portrait/stl/assembled/05 button caps.stl

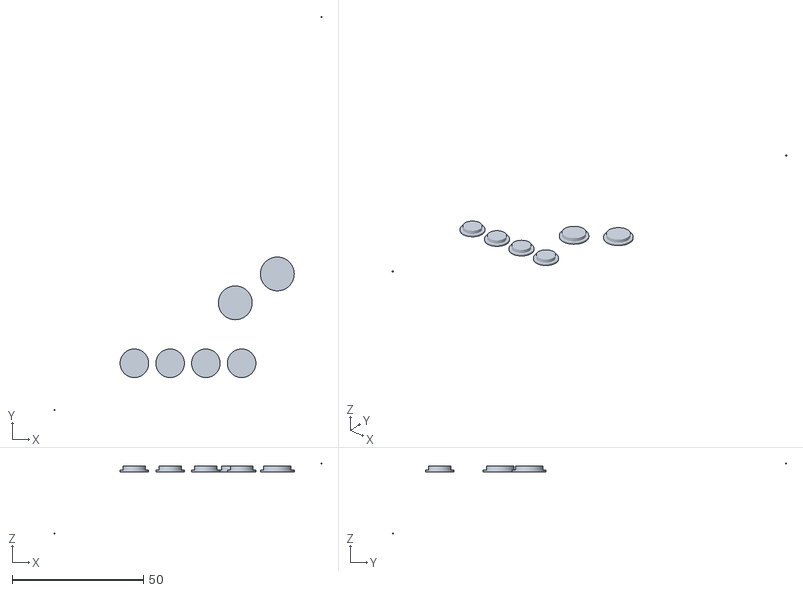
[picture p100: CAD file, 2026-10-29]
enclosure/case-portrait/stl/assembled/05 button caps.stl
102.0 x 150.0 x 26.9
