Ranbo-codez/chaipi/enclosure/case/stl/assembled/02 middle sheet.stl

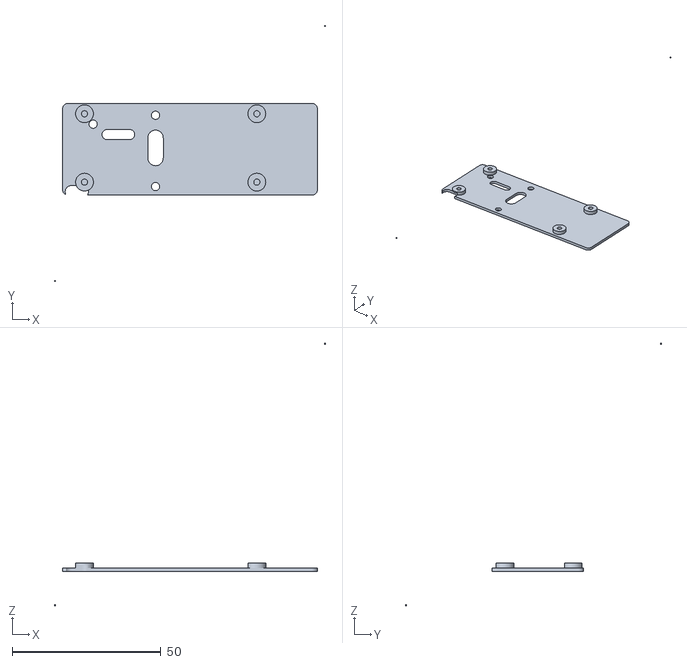
[picture p101: CAD file, 2026-10-29]
enclosure/case/stl/assembled/02 middle sheet.stl
91.2 x 86.3 x 88.4
