Ranbo-codez/chaipi/enclosure/case-landscape/stl/assembled/25 MT3608 boost.stl

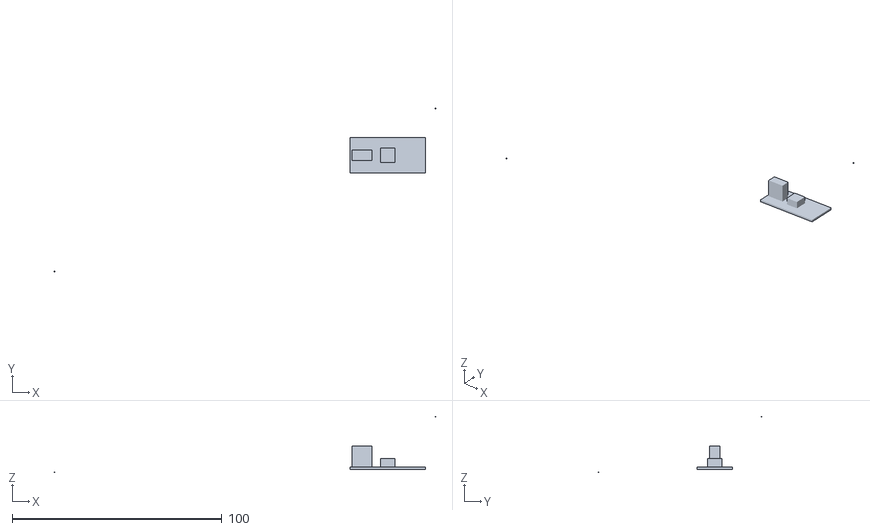
[picture p102: CAD file, 2026-10-29]
enclosure/case-landscape/stl/assembled/25 MT3608 boost.stl
182.0 x 78.0 x 26.9
