Ranbo-codez/chaipi/enclosure/case-portrait/stl/assembled/04 button carrier face buttons.stl

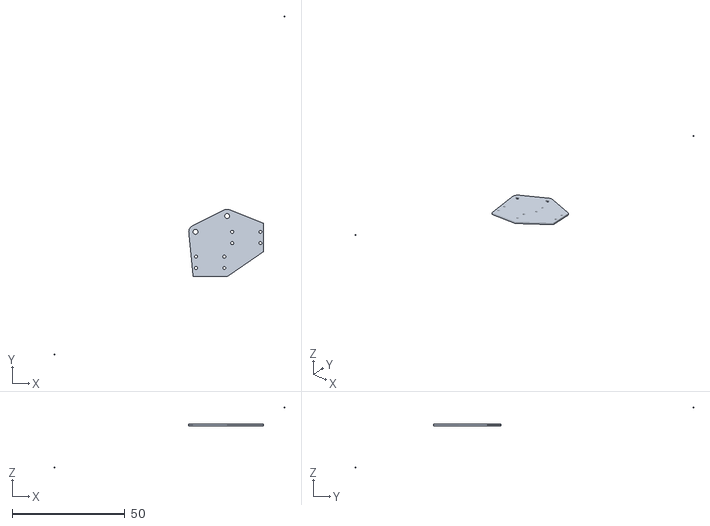
[picture p103: CAD file, 2026-10-29]
enclosure/case-portrait/stl/assembled/04 button carrier face buttons.stl
102.0 x 150.0 x 26.9
