Ranbo-codez/chaipi/enclosure/case/stl/assembled/23 joystick.stl

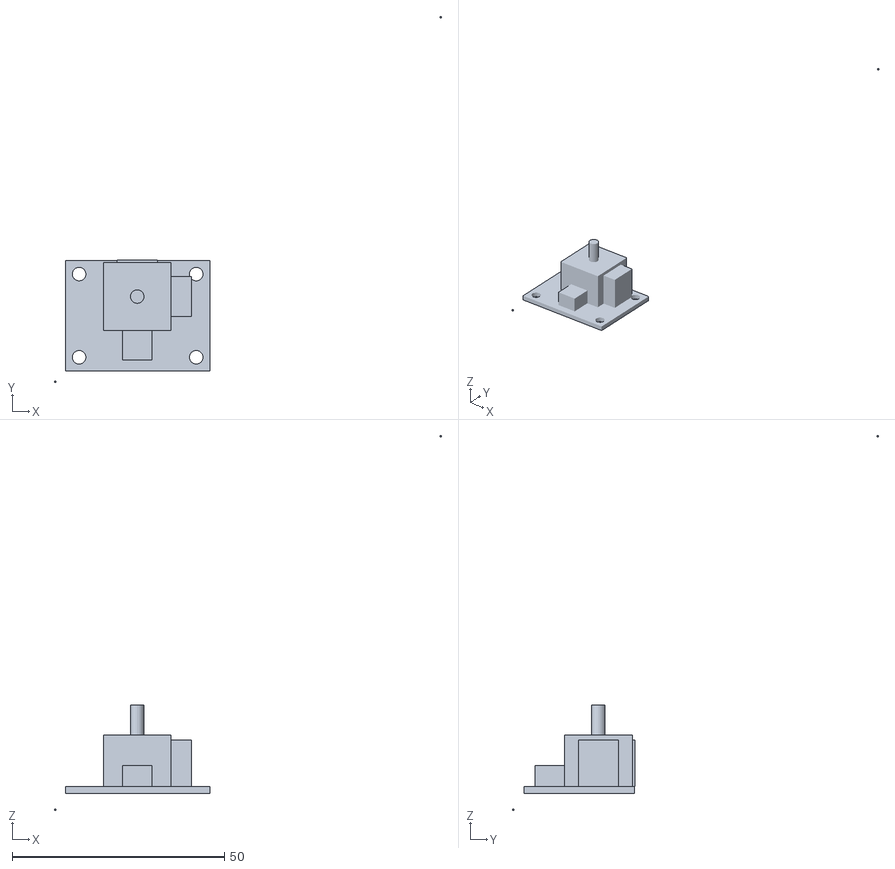
[picture p104: CAD file, 2026-10-29]
enclosure/case/stl/assembled/23 joystick.stl
91.2 x 86.3 x 88.4
