Ranbo-codez/chaipi/enclosure/case-landscape/stl/assembled/03 screen surround.stl

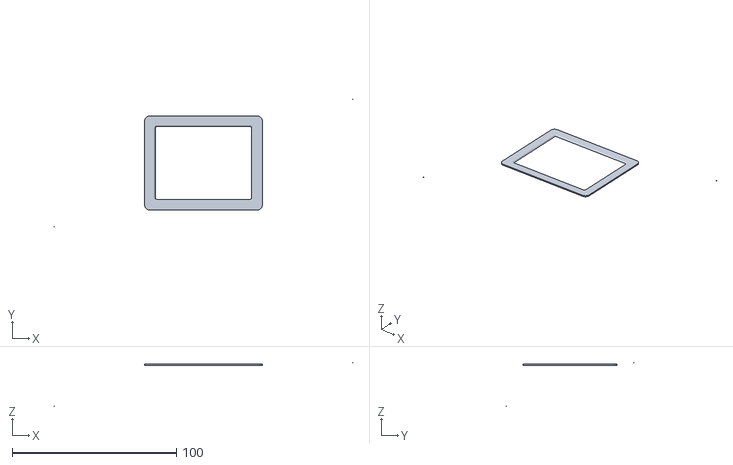
[picture p105: CAD file, 2026-10-29]
enclosure/case-landscape/stl/assembled/03 screen surround.stl
182.0 x 78.0 x 26.9
