Ranbo-codez/chaipi/enclosure/case-portrait/stl/assembled/01 tub.stl

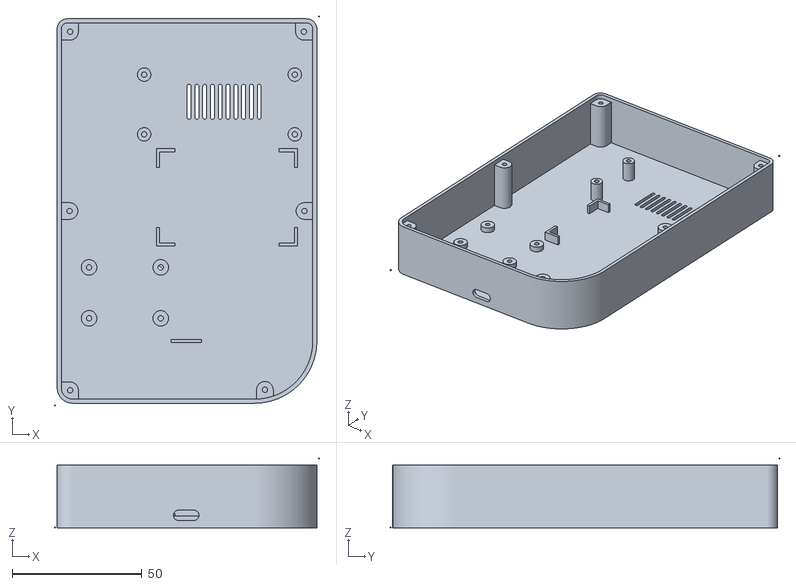
[picture p106: CAD file, 2026-10-29]
enclosure/case-portrait/stl/assembled/01 tub.stl
102.0 x 150.0 x 26.9
