Ranbo-codez/chaipi/enclosure/case-landscape/stl/assembled/02 top plate.stl

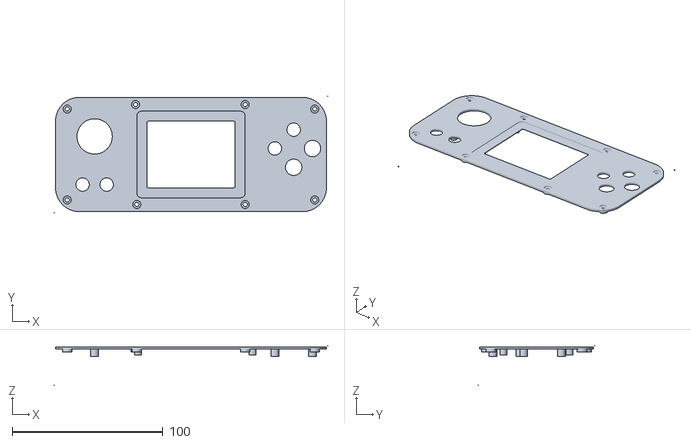
[picture p107: CAD file, 2026-10-29]
enclosure/case-landscape/stl/assembled/02 top plate.stl
182.0 x 78.0 x 26.9
