Ranbo-codez/chaipi/enclosure/case-landscape/stl/components/buttons.stl

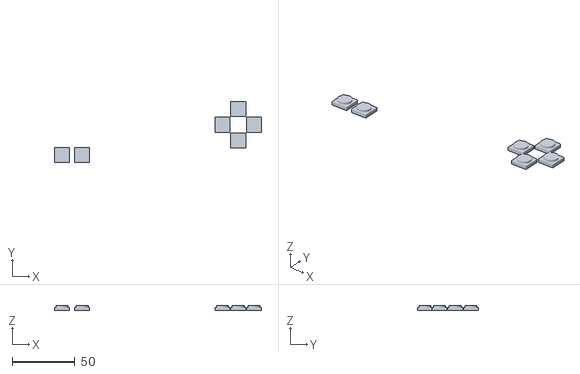
[picture p108: CAD file, 2026-10-29]
enclosure/case-landscape/stl/components/buttons.stl
164.7 x 48.5 x 4.00
