Ranbo-codez/chaipi/enclosure/case-portrait/stl/assembled/03 screen surround.stl

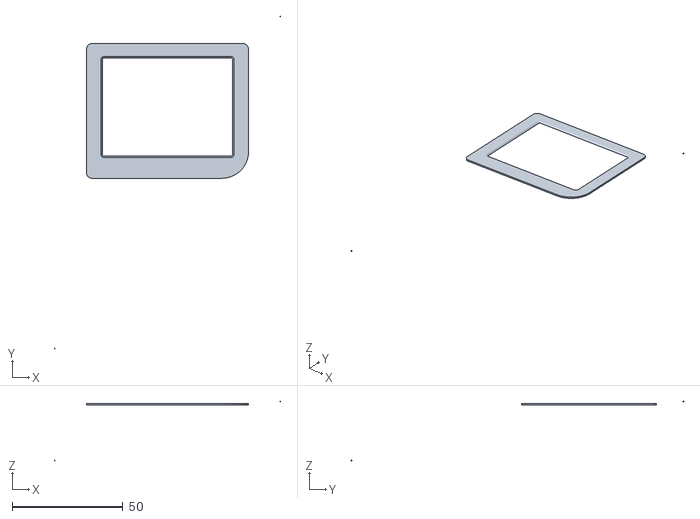
[picture p109: CAD file, 2026-10-29]
enclosure/case-portrait/stl/assembled/03 screen surround.stl
102.0 x 150.0 x 26.9
