Ranbo-codez/chaipi/enclosure/case/stl/components/DS3231_clock.stl

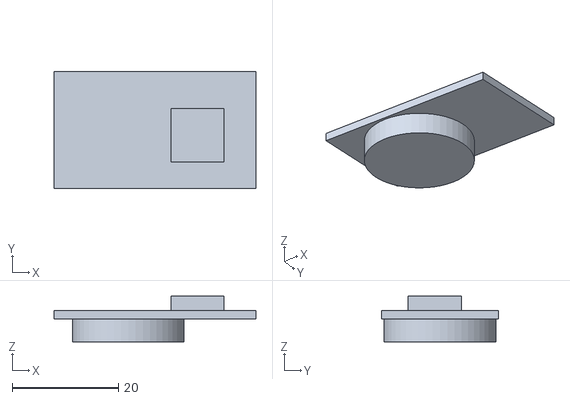
[picture p110: CAD file, 2026-10-29]
enclosure/case/stl/components/DS3231_clock.stl
38.0 x 22.0 x 8.60
