Ranbo-codez/chaipi/enclosure/case-landscape/stl/assembled/20 screen.stl

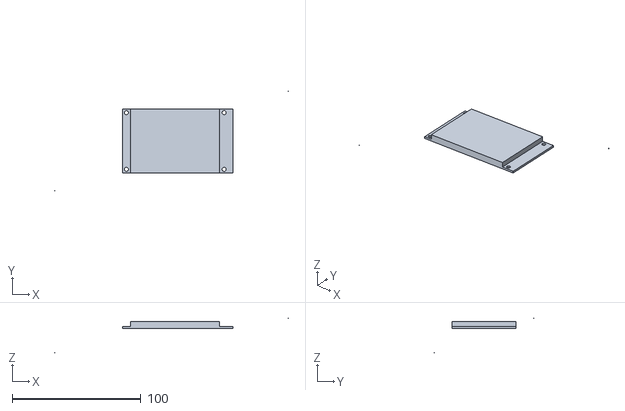
[picture p111: CAD file, 2026-10-29]
enclosure/case-landscape/stl/assembled/20 screen.stl
182.0 x 78.0 x 26.9
