Ranbo-codez/chaipi/enclosure/case-portrait/stl/assembled/20 screen.stl

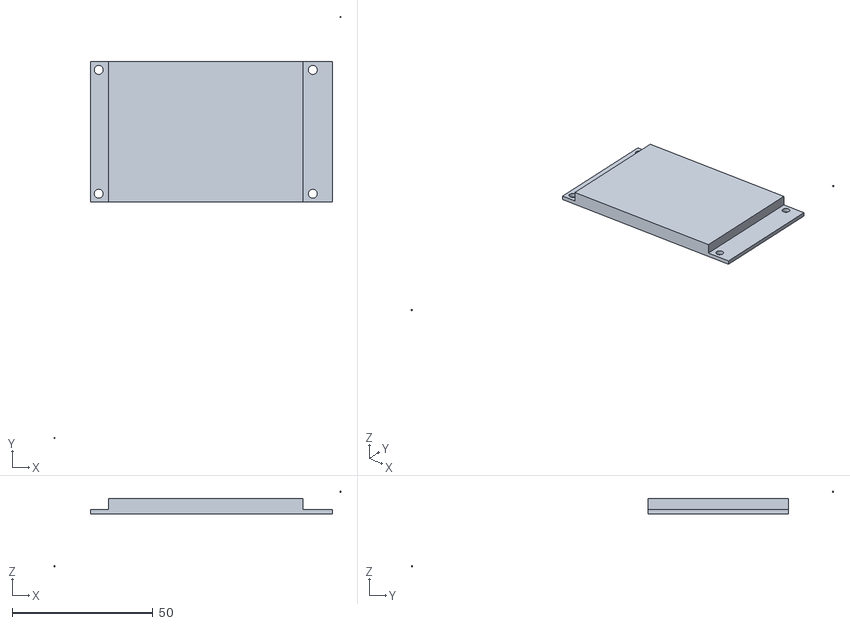
[picture p112: CAD file, 2026-10-29]
enclosure/case-portrait/stl/assembled/20 screen.stl
102.0 x 150.0 x 26.9
