Ranbo-codez/chaipi/enclosure/case-landscape/stl/assembled/05 button caps.stl

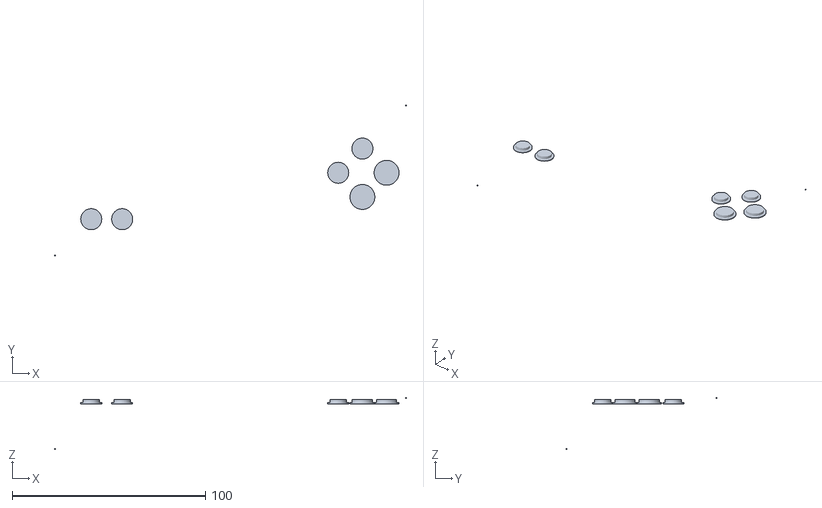
[picture p113: CAD file, 2026-10-29]
enclosure/case-landscape/stl/assembled/05 button caps.stl
182.0 x 78.0 x 26.9
