Ranbo-codez/chaipi/enclosure/case-portrait/stl/assembled/25 MT3608 boost.stl

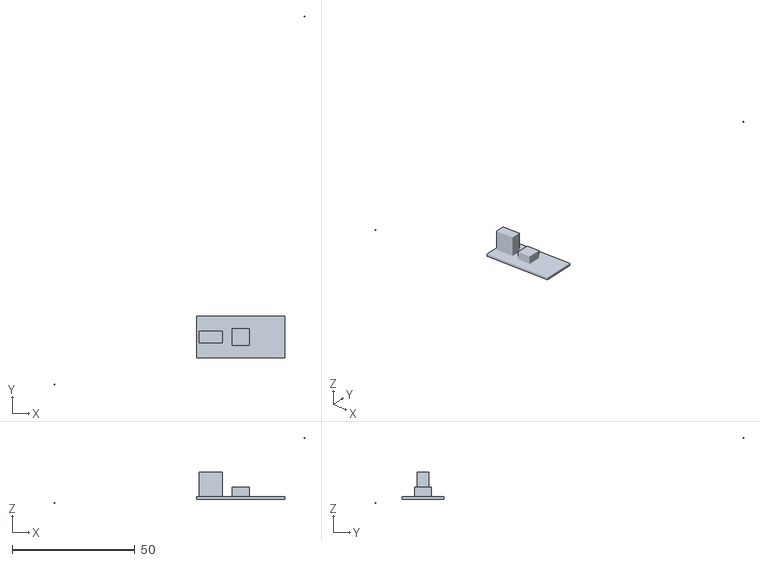
[picture p114: CAD file, 2026-10-29]
enclosure/case-portrait/stl/assembled/25 MT3608 boost.stl
102.0 x 150.0 x 26.9
