Ranbo-codez/chaipi/enclosure/case/stl/assembled/01 base tub.stl

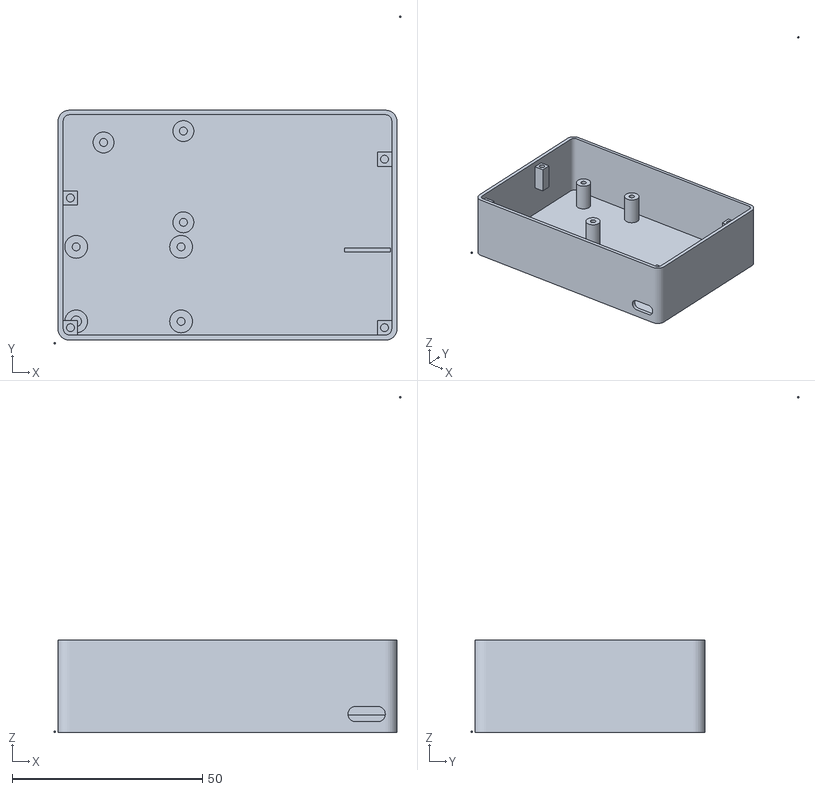
[picture p115: CAD file, 2026-10-29]
enclosure/case/stl/assembled/01 base tub.stl
91.2 x 86.3 x 88.4
