Ranbo-codez/chaipi/enclosure/case-landscape/stl/assembled/28 USB-C breakout.stl

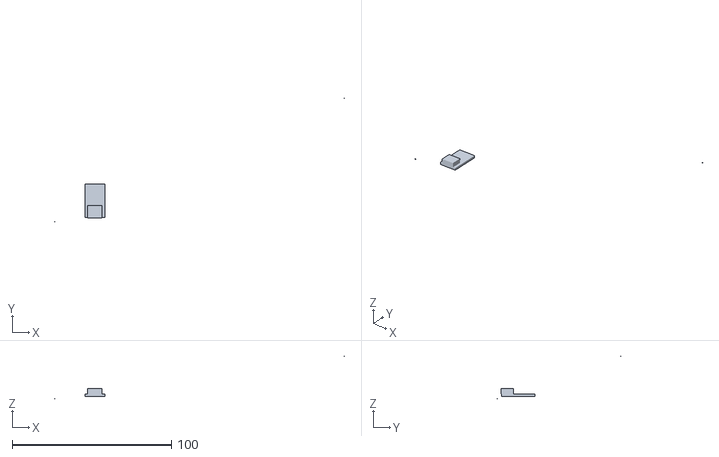
[picture p116: CAD file, 2026-10-29]
enclosure/case-landscape/stl/assembled/28 USB-C breakout.stl
182.0 x 78.0 x 26.9
