Ranbo-codez/chaipi/enclosure/case/stl/assembled/29 buttons.stl

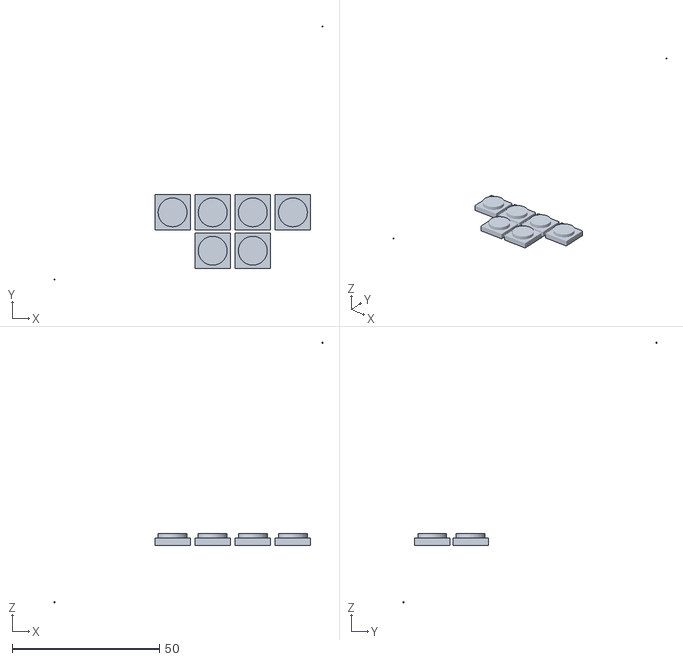
[picture p117: CAD file, 2026-10-29]
enclosure/case/stl/assembled/29 buttons.stl
91.2 x 86.3 x 88.4
