Ranbo-codez/chaipi/enclosure/case/stl/assembled/25 MT3608 boost.stl

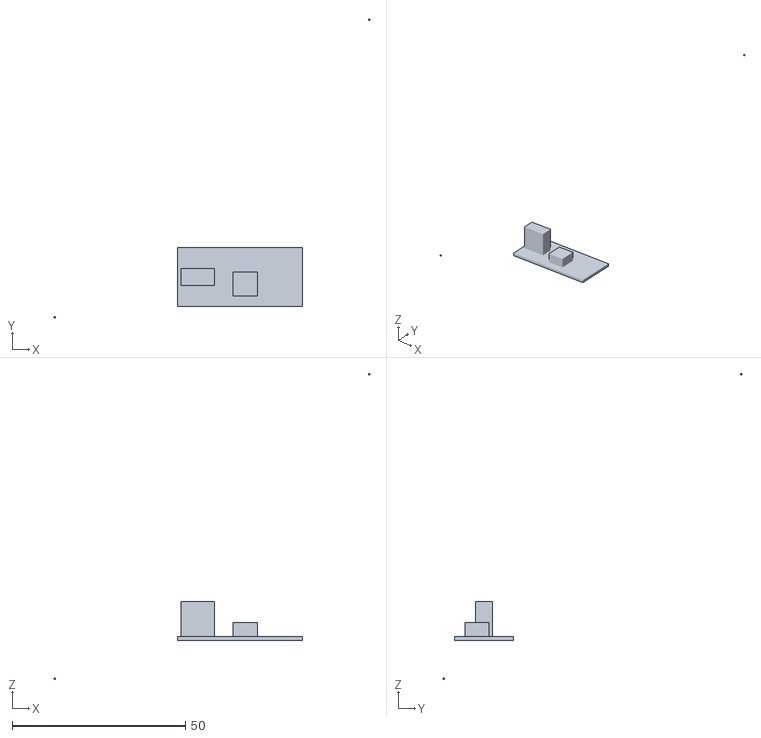
[picture p118: CAD file, 2026-10-29]
enclosure/case/stl/assembled/25 MT3608 boost.stl
91.2 x 86.3 x 88.4
