Ranbo-codez/chaipi/enclosure/case/stl/assembled/05 button caps.stl

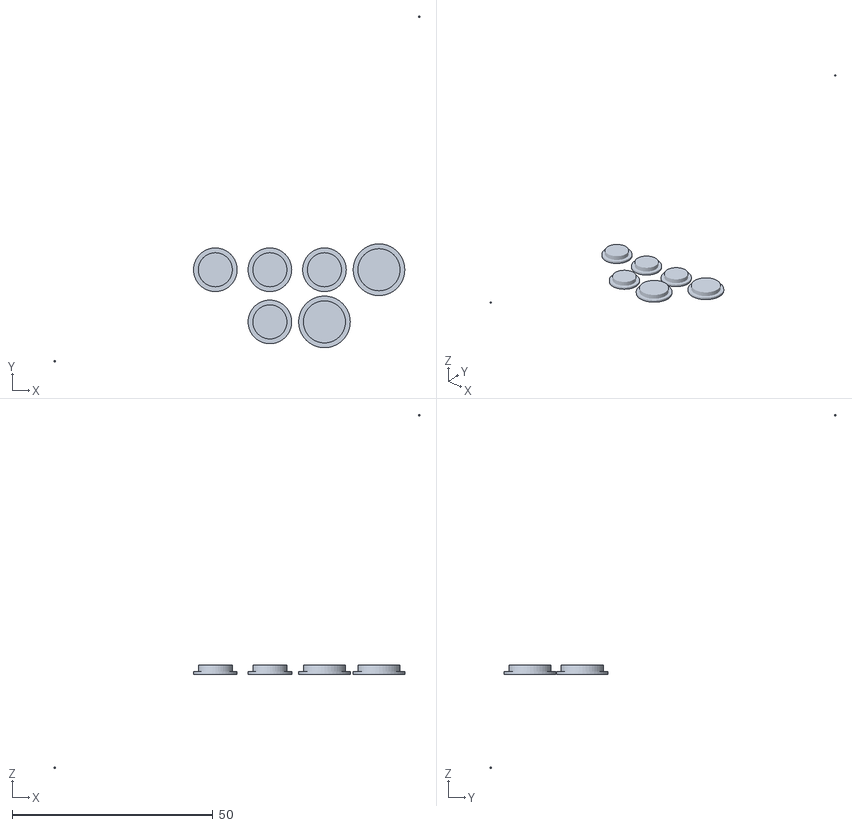
[picture p119: CAD file, 2026-10-29]
enclosure/case/stl/assembled/05 button caps.stl
91.2 x 86.3 x 88.4
