Ranbo-codez/chaipi/(list of files, cad)

Other CAD files:
enclosure/case/stl/components/heatsinks.stl
enclosure/case-portrait/stl/components/heatsinks.stl
enclosure/case-landscape/stl/components/battery.stl
enclosure/case-landscape/stl/components/DS3231_clock.stl
enclosure/case-landscape/stl/joystick_cap.stl
enclosure/case/stl/components/Pi_Zero_2_W.stl
enclosure/logo-badge/inlay_accent.stl
enclosure/case-landscape/stl/components/joystick.stl
enclosure/logo-badge/badge_berry.stl
enclosure/case-portrait/stl/components/MT3608_boost.stl
enclosure/logo-badge/inlay_ink.stl
enclosure/case-portrait/stl/components/USB-C_breakout.stl
enclosure/case/stl/components/joystick.stl
enclosure/case-landscape/stl/components/screen.stl
enclosure/case-portrait/stl/assembled/27 ADS1115.stl
enclosure/case/stl/components/battery.stl
enclosure/case-landscape/stl/components/TP4056_charger.stl
enclosure/case-portrait/stl/components/ADS1115.stl
enclosure/case/stl/assembled/04 top plate.stl
enclosure/case-landscape/stl/assembled/26 TP4056 charger.stl
enclosure/case-landscape/stl/components/Pi_Zero_2_W.stl
enclosure/case-portrait/stl/components/Pi_connectors.stl
enclosure/case/stl/components/MT3608_boost.stl
enclosure/case/stl/joystick_cap.stl
enclosure/case-landscape/stl/components/USB-C_breakout.stl
enclosure/case-portrait/stl/components/screen.stl
enclosure/case/stl/components/Pi_connectors.stl
enclosure/case-landscape/stl/components/joystick_board.stl
enclosure/case-portrait/stl/components/screen_picture.stl
enclosure/case/stl/assembled/09 lid back cover.stl
enclosure/case/stl/components/joystick_board.stl
enclosure/case-portrait/stl/components/TP4056_charger.stl
enclosure/case/stl/assembled/26 TP4056 charger.stl
enclosure/case/stl/assembled/07 hinge block.stl
enclosure/case-portrait/stl/assembled/04 button carrier small keys.stl
