Ranbo-codez/chaipi/(notices)

Notices in the files:
README.md:
License: GPL-3.0
